bhagwat-rahul/reversible-mac/src/reversible_stdcells/layout/views/rev_cnot/rev_cnot.png

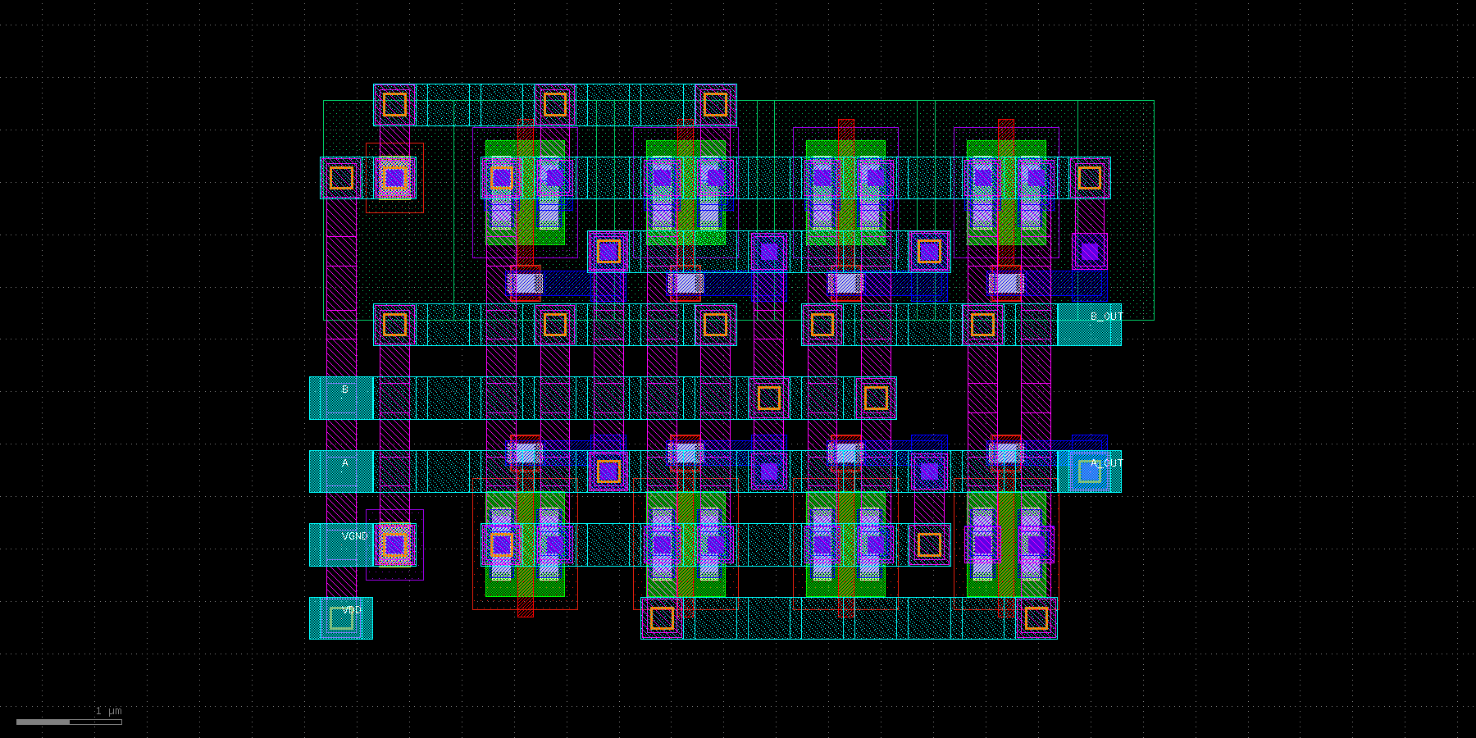
src/reversible_stdcells/layout/views/rev_cnot/rev_cnot.png
