bhagwat-rahul/reversible-mac/src/reversible_stdcells/layout/views/rev_not/rev_not.png

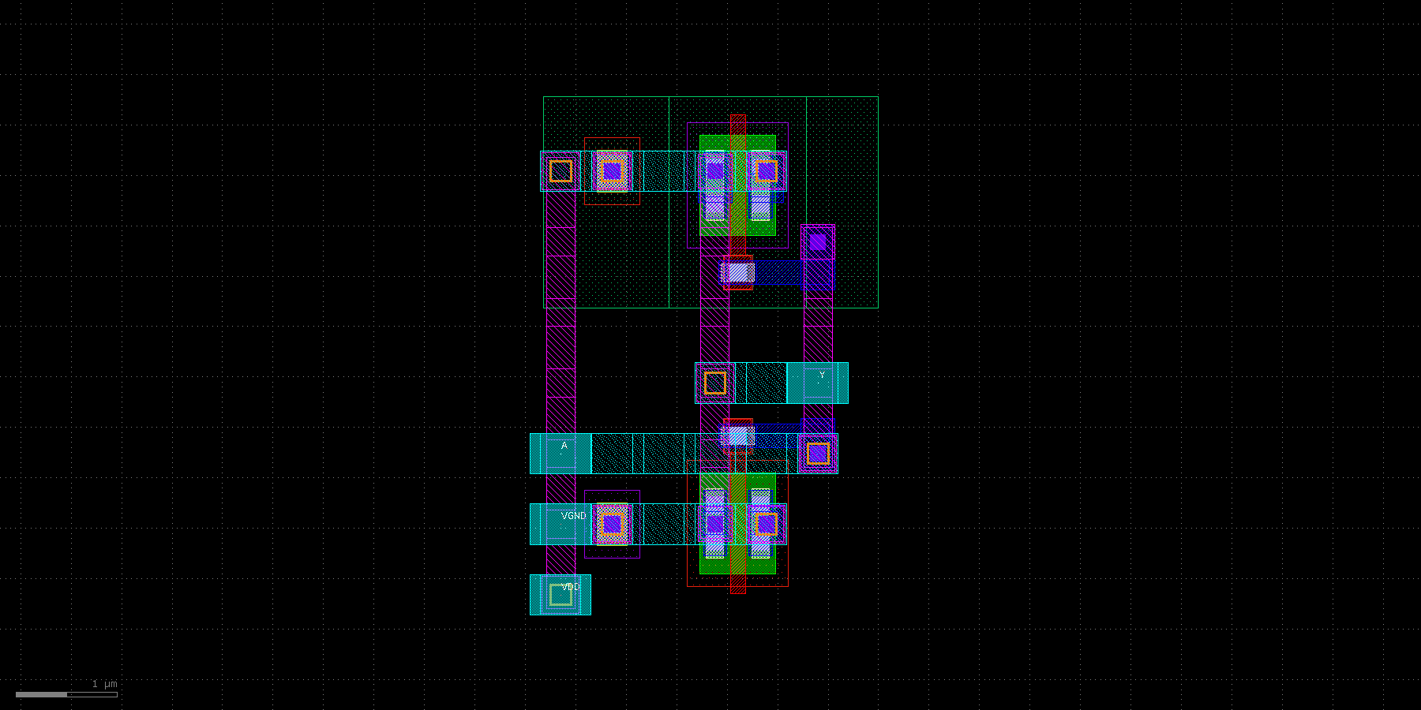
src/reversible_stdcells/layout/views/rev_not/rev_not.png
