bhagwat-rahul/reversible-mac/src/reversible_stdcells/layout/views/rev_toffoli/rev_toffoli.png

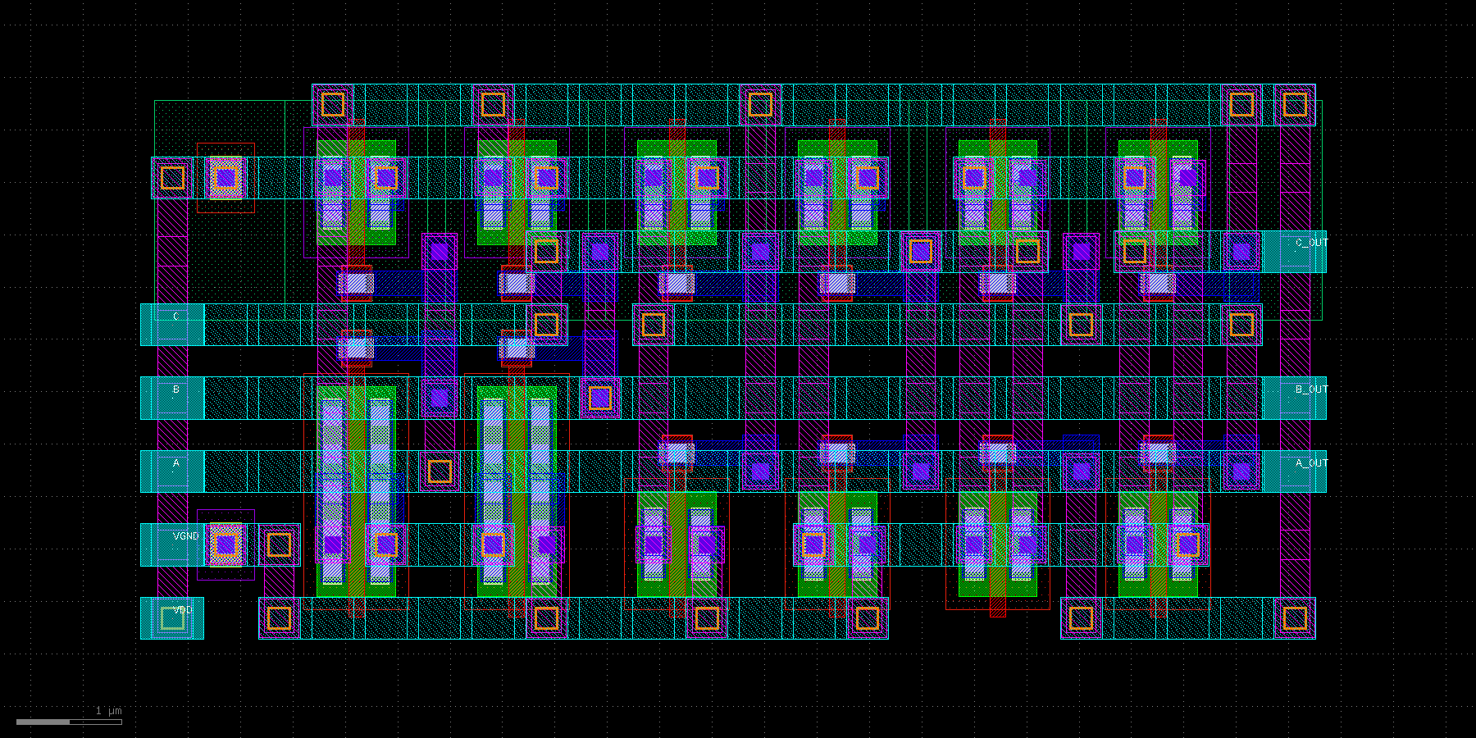
src/reversible_stdcells/layout/views/rev_toffoli/rev_toffoli.png
