bhagwat-rahul/reversible-mac/src/reversible_stdcells/layout/characterization/summary.csv

cell | corner | vdd_V | temp_C | truth_rows | directed_transitions | status | max_delay_ps | max_slew_20_80_ps
rev_not | tt | 1.8 | 27 | 2 | 2 | PASS | 94.8238 | 94.0069
rev_not | tt | 1.62 | 125 | 2 | 2 | PASS | 97.2895 | 100.489
rev_not | tt | 1.98 | -40 | 2 | 2 | PASS | 89.1665 | 86.5556
rev_not | ss | 1.8 | 27 | 2 | 2 | PASS | 128.458 | 131.5136
rev_not | ss | 1.62 | 125 | 2 | 2 | PASS | 131.9486 | 139.894
rev_not | ss | 1.98 | -40 | 2 | 2 | PASS | 119.2281 | 119.693
rev_not | ff | 1.8 | 27 | 2 | 2 | PASS | 74.9453 | 74.0854
rev_not | ff | 1.62 | 125 | 2 | 2 | PASS | 79.4098 | 80.5801
rev_not | ff | 1.98 | -40 | 2 | 2 | PASS | 70.7127 | 70.9175
rev_not | sf | 1.8 | 27 | 2 | 2 | PASS | 130.164 | 132.948
rev_not | sf | 1.62 | 125 | 2 | 2 | PASS | 137.0584 | 146.5867
rev_not | sf | 1.98 | -40 | 2 | 2 | PASS | 117.4135 | 115.9452
rev_not | fs | 1.8 | 27 | 2 | 2 | PASS | 74.0782 | 73.8267
rev_not | fs | 1.62 | 125 | 2 | 2 | PASS | 80.8062 | 82.8792
rev_not | fs | 1.98 | -40 | 2 | 2 | PASS | 68.6971 | 69.5787
rev_cnot | tt | 1.8 | 27 | 4 | 8 | PASS | 188.8786 | 247.7548
rev_cnot | tt | 1.62 | 125 | 4 | 8 | PASS | 204.3251 | 271.7079
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
