bhagwat-rahul/reversible-mac/src/reversible_stdcells/layout/characterization/timing.csv

cell | corner | vdd_V | temp_C | input | output | before | after | output_edge | delay_ps | slew_20_80_ps | ideal_wire
rev_not | tt | 1.8 | 27 | A | Y | 0 | 1 | fall | 50.8846 | 34.7106 | False
rev_not | tt | 1.8 | 27 | A | Y | 1 | 0 | rise | 94.8238 | 94.0069 | False
rev_not | tt | 1.62 | 125 | A | Y | 0 | 1 | fall | 60.8213 | 42.9861 | False
rev_not | tt | 1.62 | 125 | A | Y | 1 | 0 | rise | 97.2895 | 100.489 | False
rev_not | tt | 1.98 | -40 | A | Y | 0 | 1 | fall | 43.4602 | 30.8887 | False
rev_not | tt | 1.98 | -40 | A | Y | 1 | 0 | rise | 89.1665 | 86.5556 | False
rev_not | ss | 1.8 | 27 | A | Y | 0 | 1 | fall | 58.6605 | 38.068 | False
rev_not | ss | 1.8 | 27 | A | Y | 1 | 0 | rise | 128.458 | 131.5136 | False
rev_not | ss | 1.62 | 125 | A | Y | 0 | 1 | fall | 72.1066 | 51.0955 | False
rev_not | ss | 1.62 | 125 | A | Y | 1 | 0 | rise | 131.9486 | 139.894 | False
rev_not | ss | 1.98 | -40 | A | Y | 0 | 1 | fall | 49.837 | 31.8768 | False
rev_not | ss | 1.98 | -40 | A | Y | 1 | 0 | rise | 119.2281 | 119.693 | False
rev_not | ff | 1.8 | 27 | A | Y | 0 | 1 | fall | 43.6311 | 33.8588 | False
rev_not | ff | 1.8 | 27 | A | Y | 1 | 0 | rise | 74.9453 | 74.0854 | False
rev_not | ff | 1.62 | 125 | A | Y | 0 | 1 | fall | 52.1281 | 39.0048 | False
rev_not | ff | 1.62 | 125 | A | Y | 1 | 0 | rise | 79.4098 | 80.5801 | False
rev_not | ff | 1.98 | -40 | A | Y | 0 | 1 | fall | 36.9041 | 31.3239 | False
rev_not | ff | 1.98 | -40 | A | Y | 1 | 0 | rise | 70.7127 | 70.9175 | False
rev_not | sf | 1.8 | 27 | A | Y | 0 | 1 | fall | 42.9238 | 33.6043 | False
rev_not | sf | 1.8 | 27 | A | Y | 1 | 0 | rise | 130.164 | 132.948 | False
rev_not | sf | 1.62 | 125 | A | Y | 0 | 1 | fall | 51.2985 | 38.6279 | False
rev_not | sf | 1.62 | 125 | A | Y | 1 | 0 | rise | 137.0584 | 146.5867 | False
rev_not | sf | 1.98 | -40 | A | Y | 0 | 1 | fall | 36.2476 | 31.2423 | False
rev_not | sf | 1.98 | -40 | A | Y | 1 | 0 | rise | 117.4135 | 115.9452 | False
rev_not | fs | 1.8 | 27 | A | Y | 0 | 1 | fall | 59.468 | 38.147 | False
rev_not | fs | 1.8 | 27 | A | Y | 1 | 0 | rise | 74.0782 | 73.8267 | False
rev_not | fs | 1.62 | 125 | A | Y | 0 | 1 | fall | 73.7753 | 52.284 | False
rev_not | fs | 1.62 | 125 | A | Y | 1 | 0 | rise | 80.8062 | 82.8792 | False
rev_not | fs | 1.98 | -40 | A | Y | 0 | 1 | fall | 50.2643 | 31.4972 | False
rev_not | fs | 1.98 | -40 | A | Y | 1 | 0 | rise | 68.6971 | 69.5787 | False
rev_cnot | tt | 1.8 | 27 | A | A_OUT | 00 | 10 | rise | 0.0 | 60.0 | True
rev_cnot | tt | 1.8 | 27 | A | B_OUT | 00 | 10 | rise | 140.6922 | 232.3154 | False
rev_cnot | tt | 1.8 | 27 | B | B_OUT | 00 | 01 | rise | 48.1538 | 132.059 | False
rev_cnot | tt | 1.8 | 27 | A | A_OUT | 01 | 11 | rise | 0.0 | 60.0 | True
rev_cnot | tt | 1.8 | 27 | A | B_OUT | 01 | 11 | fall | 66.3974 | 60.8024 | False
rev_cnot | tt | 1.8 | 27 | B | B_OUT | 01 | 00 | fall | 47.8448 | 55.7099 | False
rev_cnot | tt | 1.8 | 27 | A | A_OUT | 10 | 00 | fall | 0.0 | 60.0 | True
rev_cnot | tt | 1.8 | 27 | A | B_OUT | 10 | 00 | fall | 102.8928 | 57.9365 | False
rev_cnot | tt | 1.8 | 27 | B | B_OUT | 10 | 11 | fall | 91.3338 | 63.5462 | False
rev_cnot | tt | 1.8 | 27 | A | A_OUT | 11 | 01 | fall | 0.0 | 60.0 | True
rev_cnot | tt | 1.8 | 27 | A | B_OUT | 11 | 01 | rise | 103.6772 | 111.3175 | False
rev_cnot | tt | 1.8 | 27 | B | B_OUT | 11 | 10 | rise | 188.8786 | 247.7548 | False
rev_cnot | tt | 1.62 | 125 | A | A_OUT | 00 | 10 | rise | 0.0 | 60.0 | True
rev_cnot | tt | 1.62 | 125 | A | B_OUT | 00 | 10 | rise | 159.7484 | 257.2705 | False
rev_cnot | tt | 1.62 | 125 | B | B_OUT | 00 | 01 | rise | 54.8647 | 138.4132 | False
rev_cnot | tt | 1.62 | 125 | A | A_OUT | 01 | 11 | rise | 0.0 | 60.0 | True
rev_cnot | tt | 1.62 | 125 | A | B_OUT | 01 | 11 | fall | 84.6317 | 86.733 | False
rev_cnot | tt | 1.62 | 125 | B | B_OUT | 01 | 00 | fall | 54.0511 | 66.6337 | False
rev_cnot | tt | 1.62 | 125 | A | A_OUT | 10 | 00 | fall | 0.0 | 60.0 | True
rev_cnot | tt | 1.62 | 125 | A | B_OUT | 10 | 00 | fall | 112.6734 | 73.057 | False
rev_cnot | tt | 1.62 | 125 | B | B_OUT | 10 | 11 | fall | 116.3348 | 92.336 | False
rev_cnot | tt | 1.62 | 125 | A | A_OUT | 11 | 01 | fall | 0.0 | 60.0 | True
rev_cnot | tt | 1.62 | 125 | A | B_OUT | 11 | 01 | rise | 107.5925 | 120.0515 | False
rev_cnot | tt | 1.62 | 125 | B | B_OUT | 11 | 10 | rise | 204.3251 | 271.7079 | False
rev_cnot | tt | 1.98 | -40 | A | A_OUT | 00 | 10 | rise | 0.0 | 60.0 | True
rev_cnot | tt | 1.98 | -40 | A | B_OUT | 00 | 10 | rise | 120.9535 | 205.3493 | False
rev_cnot | tt | 1.98 | -40 | B | B_OUT | 00 | 01 | rise | 40.5454 | 123.8615 | False
rev_cnot | tt | 1.98 | -40 | A | A_OUT | 01 | 11 | rise | 0.0 | 60.0 | True
rev_cnot | tt | 1.98 | -40 | A | B_OUT | 01 | 11 | fall | 54.3832 | 46.8483 | False
rev_cnot | tt | 1.98 | -40 | B | B_OUT | 01 | 00 | fall | 42.2526 | 49.4588 | False
rev_cnot | tt | 1.98 | -40 | A | A_OUT | 10 | 00 | fall | 0.0 | 60.0 | True
rev_cnot | tt | 1.98 | -40 | A | B_OUT | 10 | 00 | fall | 92.5668 | 48.043 | False
rev_cnot | tt | 1.98 | -40 | B | B_OUT | 10 | 11 | fall | 75.0309 | 47.2699 | False
rev_cnot | tt | 1.98 | -40 | A | A_OUT | 11 | 01 | fall | 0.0 | 60.0 | True
rev_cnot | tt | 1.98 | -40 | A | B_OUT | 11 | 01 | rise | 96.1563 | 101.307 | False
rev_cnot | tt | 1.98 | -40 | B | B_OUT | 11 | 10 | rise | 168.4699 | 221.3229 | False
rev_cnot | ss | 1.8 | 27 | A | A_OUT | 00 | 10 | rise | 0.0 | 60.0 | True
rev_cnot | ss | 1.8 | 27 | A | B_OUT | 00 | 10 | rise | 200.9691 | 340.167 | False
rev_cnot | ss | 1.8 | 27 | B | B_OUT | 00 | 01 | rise | 63.8168 | 170.3515 | False
rev_cnot | ss | 1.8 | 27 | A | A_OUT | 01 | 11 | rise | 0.0 | 60.0 | True
rev_cnot | ss | 1.8 | 27 | A | B_OUT | 01 | 11 | fall | 80.4799 | 73.846 | False
rev_cnot | ss | 1.8 | 27 | B | B_OUT | 01 | 00 | fall | 57.6008 | 59.1927 | False
rev_cnot | ss | 1.8 | 27 | A | A_OUT | 10 | 00 | fall | 0.0 | 60.0 | True
rev_cnot | ss | 1.8 | 27 | A | B_OUT | 10 | 00 | fall | 139.75 | 73.2689 | False
rev_cnot | ss | 1.8 | 27 | B | B_OUT | 10 | 11 | fall | 111.115 | 77.9985 | False
rev_cnot | ss | 1.8 | 27 | A | A_OUT | 11 | 01 | fall | 0.0 | 60.0 | True
rev_cnot | ss | 1.8 | 27 | A | B_OUT | 11 | 01 | rise | 143.1473 | 157.7493 | False
rev_cnot | ss | 1.8 | 27 | B | B_OUT | 11 | 10 | rise | 274.0051 | 359.4857 | False
rev_cnot | ss | 1.62 | 125 | A | A_OUT | 00 | 10 | rise | 0.0 | 60.0 | True
rev_cnot | ss | 1.62 | 125 | A | B_OUT | 00 | 10 | rise | 226.2285 | 372.8059 | False
rev_cnot | ss | 1.62 | 125 | B | B_OUT | 00 | 01 | rise | 74.4654 | 180.7988 | False
rev_cnot | ss | 1.62 | 125 | A | A_OUT | 01 | 11 | rise | 0.0 | 60.0 | True
rev_cnot | ss | 1.62 | 125 | A | B_OUT | 01 | 11 | fall | 107.2095 | 113.0137 | False
rev_cnot | ss | 1.62 | 125 | B | B_OUT | 01 | 00 | fall | 67.3718 | 76.3632 | False
rev_cnot | ss | 1.62 | 125 | A | A_OUT | 10 | 00 | fall | 0.0 | 60.0 | True
rev_cnot | ss | 1.62 | 125 | A | B_OUT | 10 | 00 | fall | 155.3688 | 95.9913 | False
rev_cnot | ss | 1.62 | 125 | B | B_OUT | 10 | 11 | fall | 148.0193 | 119.306 | False
rev_cnot | ss | 1.62 | 125 | A | A_OUT | 11 | 01 | fall | 0.0 | 60.0 | True
rev_cnot | ss | 1.62 | 125 | A | B_OUT | 11 | 01 | rise | 148.1143 | 168.7293 | False
rev_cnot | ss | 1.62 | 125 | B | B_OUT | 11 | 10 | rise | 294.8149 | 392.3502 | False
rev_cnot | ss | 1.98 | -40 | A | A_OUT | 00 | 10 | rise | 0.0 | 60.0 | True
rev_cnot | ss | 1.98 | -40 | A | B_OUT | 00 | 10 | rise | 171.7918 | 298.5422 | False
rev_cnot | ss | 1.98 | -40 | B | B_OUT | 00 | 01 | rise | 53.0541 | 155.8779 | False
rev_cnot | ss | 1.98 | -40 | A | A_OUT | 01 | 11 | rise | 0.0 | 60.0 | True
rev_cnot | ss | 1.98 | -40 | A | B_OUT | 01 | 11 | fall | 63.725 | 52.9904 | False
rev_cnot | ss | 1.98 | -40 | B | B_OUT | 01 | 00 | fall | 50.0802 | 49.8892 | False
rev_cnot | ss | 1.98 | -40 | A | A_OUT | 10 | 00 | fall | 0.0 | 60.0 | True
rev_cnot | ss | 1.98 | -40 | A | B_OUT | 10 | 00 | fall | 123.0162 | 58.8739 | False
rev_cnot | ss | 1.98 | -40 | B | B_OUT | 10 | 11 | fall | 87.871 | 54.805 | False
rev_cnot | ss | 1.98 | -40 | A | A_OUT | 11 | 01 | fall | 0.0 | 60.0 | True
rev_cnot | ss | 1.98 | -40 | A | B_OUT | 11 | 01 | rise | 131.5463 | 142.5902 | False
rev_cnot | ss | 1.98 | -40 | B | B_OUT | 11 | 10 | rise | 241.8469 | 317.1326 | False
rev_cnot | ff | 1.8 | 27 | A | A_OUT | 00 | 10 | rise | 0.0 | 60.0 | True
rev_cnot | ff | 1.8 | 27 | A | B_OUT | 00 | 10 | rise | 104.1547 | 170.9508 | False
rev_cnot | ff | 1.8 | 27 | B | B_OUT | 00 | 01 | rise | 36.3806 | 110.154 | False
rev_cnot | ff | 1.8 | 27 | A | A_OUT | 01 | 11 | rise | 0.0 | 60.0 | True
rev_cnot | ff | 1.8 | 27 | A | B_OUT | 01 | 11 | fall | 55.129 | 52.8235 | False
rev_cnot | ff | 1.8 | 27 | B | B_OUT | 01 | 00 | fall | 39.6704 | 54.308 | False
rev_cnot | ff | 1.8 | 27 | A | A_OUT | 10 | 00 | fall | 0.0 | 60.0 | True
rev_cnot | ff | 1.8 | 27 | A | B_OUT | 10 | 00 | fall | 80.1829 | 48.0396 | False
rev_cnot | ff | 1.8 | 27 | B | B_OUT | 10 | 11 | fall | 76.7633 | 54.3077 | False
rev_cnot | ff | 1.8 | 27 | A | A_OUT | 11 | 01 | fall | 0.0 | 60.0 | True
rev_cnot | ff | 1.8 | 27 | A | B_OUT | 11 | 01 | rise | 80.0837 | 85.3624 | False
rev_cnot | ff | 1.8 | 27 | B | B_OUT | 11 | 10 | rise | 139.83 | 184.7196 | False
rev_cnot | ff | 1.62 | 125 | A | A_OUT | 00 | 10 | rise | 0.0 | 60.0 | True
rev_cnot | ff | 1.62 | 125 | A | B_OUT | 00 | 10 | rise | 121.2577 | 194.8915 | False
rev_cnot | ff | 1.62 | 125 | B | B_OUT | 00 | 01 | rise | 43.2675 | 115.9133 | False
rev_cnot | ff | 1.62 | 125 | A | A_OUT | 01 | 11 | rise | 0.0 | 60.0 | True
rev_cnot | ff | 1.62 | 125 | A | B_OUT | 01 | 11 | fall | 68.6158 | 70.6224 | False
rev_cnot | ff | 1.62 | 125 | B | B_OUT | 01 | 00 | fall | 45.1907 | 61.2934 | False
rev_cnot | ff | 1.62 | 125 | A | A_OUT | 10 | 00 | fall | 0.0 | 60.0 | True
rev_cnot | ff | 1.62 | 125 | A | B_OUT | 10 | 00 | fall | 89.1537 | 59.0149 | False
rev_cnot | ff | 1.62 | 125 | B | B_OUT | 10 | 11 | fall | 95.0682 | 74.8172 | False
rev_cnot | ff | 1.62 | 125 | A | A_OUT | 11 | 01 | fall | 0.0 | 60.0 | True
rev_cnot | ff | 1.62 | 125 | A | B_OUT | 11 | 01 | rise | 86.0325 | 94.1628 | False
rev_cnot | ff | 1.62 | 125 | B | B_OUT | 11 | 10 | rise | 156.3398 | 207.3407 | False
rev_cnot | ff | 1.98 | -40 | A | A_OUT | 00 | 10 | rise | 0.0 | 60.0 | True
rev_cnot | ff | 1.98 | -40 | A | B_OUT | 00 | 10 | rise | 91.036 | 156.7709 | False
rev_cnot | ff | 1.98 | -40 | B | B_OUT | 00 | 01 | rise | 29.1015 | 106.1115 | False
rev_cnot | ff | 1.98 | -40 | A | A_OUT | 01 | 11 | rise | 0.0 | 60.0 | True
rev_cnot | ff | 1.98 | -40 | A | B_OUT | 01 | 11 | fall | 45.7458 | 43.1946 | False
rev_cnot | ff | 1.98 | -40 | B | B_OUT | 01 | 00 | fall | 34.9439 | 49.7274 | False
rev_cnot | ff | 1.98 | -40 | A | A_OUT | 10 | 00 | fall | 0.0 | 60.0 | True
rev_cnot | ff | 1.98 | -40 | A | B_OUT | 10 | 00 | fall | 72.6251 | 41.4953 | False
rev_cnot | ff | 1.98 | -40 | B | B_OUT | 10 | 11 | fall | 64.7337 | 43.3159 | False
rev_cnot | ff | 1.98 | -40 | A | A_OUT | 11 | 01 | fall | 0.0 | 60.0 | True
rev_cnot | ff | 1.98 | -40 | A | B_OUT | 11 | 01 | rise | 74.4826 | 80.4287 | False
rev_cnot | ff | 1.98 | -40 | B | B_OUT | 11 | 10 | rise | 125.9937 | 170.5003 | False
rev_cnot | sf | 1.8 | 27 | A | A_OUT | 00 | 10 | rise | 0.0 | 60.0 | True
rev_cnot | sf | 1.8 | 27 | A | B_OUT | 00 | 10 | rise | 152.8283 | 321.3876 | False
rev_cnot | sf | 1.8 | 27 | B | B_OUT | 00 | 01 | rise | 42.6861 | 153.0774 | False
rev_cnot | sf | 1.8 | 27 | A | A_OUT | 01 | 11 | rise | 0.0 | 60.0 | True
rev_cnot | sf | 1.8 | 27 | A | B_OUT | 01 | 11 | fall | 56.0094 | 52.8323 | False
rev_cnot | sf | 1.8 | 27 | B | B_OUT | 01 | 00 | fall | 46.7782 | 48.7042 | False
rev_cnot | sf | 1.8 | 27 | A | A_OUT | 10 | 00 | fall | 0.0 | 60.0 | True
rev_cnot | sf | 1.8 | 27 | A | B_OUT | 10 | 00 | fall | 124.1258 | 58.682 | False
rev_cnot | sf | 1.8 | 27 | B | B_OUT | 10 | 11 | fall | 79.1173 | 53.1787 | False
rev_cnot | sf | 1.8 | 27 | A | A_OUT | 11 | 01 | fall | 0.0 | 60.0 | True
rev_cnot | sf | 1.8 | 27 | A | B_OUT | 11 | 01 | rise | 134.307 | 147.7336 | False
rev_cnot | sf | 1.8 | 27 | B | B_OUT | 11 | 10 | rise | 239.006 | 342.6523 | False
rev_cnot | sf | 1.62 | 125 | A | A_OUT | 00 | 10 | rise | 0.0 | 60.0 | True
rev_cnot | sf | 1.62 | 125 | A | B_OUT | 00 | 10 | rise | 178.2536 | 369.1235 | False
rev_cnot | sf | 1.62 | 125 | B | B_OUT | 00 | 01 | rise | 50.9841 | 168.7987 | False
rev_cnot | sf | 1.62 | 125 | A | A_OUT | 01 | 11 | rise | 0.0 | 60.0 | True
rev_cnot | sf | 1.62 | 125 | A | B_OUT | 01 | 11 | fall | 70.0031 | 70.5143 | False
rev_cnot | sf | 1.62 | 125 | B | B_OUT | 01 | 00 | fall | 53.276 | 57.0602 | False
rev_cnot | sf | 1.62 | 125 | A | A_OUT | 10 | 00 | fall | 0.0 | 60.0 | True
rev_cnot | sf | 1.62 | 125 | A | B_OUT | 10 | 00 | fall | 137.6415 | 72.4534 | False
rev_cnot | sf | 1.62 | 125 | B | B_OUT | 10 | 11 | fall | 98.868 | 73.8113 | False
rev_cnot | sf | 1.62 | 125 | A | A_OUT | 11 | 01 | fall | 0.0 | 60.0 | True
rev_cnot | sf | 1.62 | 125 | A | B_OUT | 11 | 01 | rise | 145.7714 | 167.7924 | False
rev_cnot | sf | 1.62 | 125 | B | B_OUT | 11 | 10 | rise | 266.5165 | 390.342 | False
rev_cnot | sf | 1.98 | -40 | A | A_OUT | 00 | 10 | rise | 0.0 | 60.0 | True
rev_cnot | sf | 1.98 | -40 | A | B_OUT | 00 | 10 | rise | 125.5919 | 269.8068 | False
rev_cnot | sf | 1.98 | -40 | B | B_OUT | 00 | 01 | rise | 33.4922 | 136.75 | False
rev_cnot | sf | 1.98 | -40 | A | A_OUT | 01 | 11 | rise | 0.0 | 60.0 | True
rev_cnot | sf | 1.98 | -40 | A | B_OUT | 01 | 11 | fall | 46.571 | 43.4696 | False
rev_cnot | sf | 1.98 | -40 | B | B_OUT | 01 | 00 | fall | 40.9298 | 44.4052 | False
rev_cnot | sf | 1.98 | -40 | A | A_OUT | 10 | 00 | fall | 0.0 | 60.0 | True
rev_cnot | sf | 1.98 | -40 | A | B_OUT | 10 | 00 | fall | 109.183 | 49.067 | False
rev_cnot | sf | 1.98 | -40 | B | B_OUT | 10 | 11 | fall | 66.1893 | 42.1216 | False
rev_cnot | sf | 1.98 | -40 | A | A_OUT | 11 | 01 | fall | 0.0 | 60.0 | True
rev_cnot | sf | 1.98 | -40 | A | B_OUT | 11 | 01 | rise | 117.8882 | 125.2103 | False
rev_cnot | sf | 1.98 | -40 | B | B_OUT | 11 | 10 | rise | 203.6922 | 289.7277 | False
rev_cnot | fs | 1.8 | 27 | A | A_OUT | 00 | 10 | rise | 0.0 | 60.0 | True
rev_cnot | fs | 1.8 | 27 | A | B_OUT | 00 | 10 | rise | 131.7733 | 177.5811 | False
rev_cnot | fs | 1.8 | 27 | B | B_OUT | 00 | 01 | rise | 48.5049 | 114.4813 | False
rev_cnot | fs | 1.8 | 27 | A | A_OUT | 01 | 11 | rise | 0.0 | 60.0 | True
rev_cnot | fs | 1.8 | 27 | A | B_OUT | 01 | 11 | fall | 78.1332 | 73.1353 | False
rev_cnot | fs | 1.8 | 27 | B | B_OUT | 01 | 00 | fall | 47.6871 | 66.2366 | False
rev_cnot | fs | 1.8 | 27 | A | A_OUT | 10 | 00 | fall | 0.0 | 60.0 | True
rev_cnot | fs | 1.8 | 27 | A | B_OUT | 10 | 00 | fall | 88.5709 | 60.1676 | False
rev_cnot | fs | 1.8 | 27 | B | B_OUT | 10 | 11 | fall | 105.4768 | 78.5407 | False
rev_cnot | fs | 1.8 | 27 | A | A_OUT | 11 | 01 | fall | 0.0 | 60.0 | True
rev_cnot | fs | 1.8 | 27 | A | B_OUT | 11 | 01 | rise | 82.2669 | 88.0274 | False
rev_cnot | fs | 1.8 | 27 | B | B_OUT | 11 | 10 | rise | 154.8425 | 189.4564 | False
rev_cnot | fs | 1.62 | 125 | A | A_OUT | 00 | 10 | rise | 0.0 | 60.0 | True
rev_cnot | fs | 1.62 | 125 | A | B_OUT | 00 | 10 | rise | 155.8652 | 205.4333 | False
rev_cnot | fs | 1.62 | 125 | B | B_OUT | 00 | 01 | rise | 56.4887 | 121.1697 | False
rev_cnot | fs | 1.62 | 125 | A | A_OUT | 01 | 11 | rise | 0.0 | 60.0 | True
rev_cnot | fs | 1.62 | 125 | A | B_OUT | 01 | 11 | fall | 103.7313 | 112.8249 | False
rev_cnot | fs | 1.62 | 125 | B | B_OUT | 01 | 00 | fall | 55.3525 | 80.1419 | False
rev_cnot | fs | 1.62 | 125 | A | A_OUT | 10 | 00 | fall | 0.0 | 60.0 | True
rev_cnot | fs | 1.62 | 125 | A | B_OUT | 10 | 00 | fall | 102.7467 | 80.4966 | False
rev_cnot | fs | 1.62 | 125 | B | B_OUT | 10 | 11 | fall | 140.1504 | 121.5885 | False
rev_cnot | fs | 1.62 | 125 | A | A_OUT | 11 | 01 | fall | 0.0 | 60.0 | True
rev_cnot | fs | 1.62 | 125 | A | B_OUT | 11 | 01 | rise | 90.1874 | 99.4413 | False
rev_cnot | fs | 1.62 | 125 | B | B_OUT | 11 | 10 | rise | 177.5565 | 216.4492 | False
rev_cnot | fs | 1.98 | -40 | A | A_OUT | 00 | 10 | rise | 0.0 | 60.0 | True
rev_cnot | fs | 1.98 | -40 | A | B_OUT | 00 | 10 | rise | 114.4636 | 161.3789 | False
rev_cnot | fs | 1.98 | -40 | B | B_OUT | 00 | 01 | rise | 41.2213 | 110.3675 | False
rev_cnot | fs | 1.98 | -40 | A | A_OUT | 01 | 11 | rise | 0.0 | 60.0 | True
rev_cnot | fs | 1.98 | -40 | A | B_OUT | 01 | 11 | fall | 61.7956 | 51.8248 | False
rev_cnot | fs | 1.98 | -40 | B | B_OUT | 01 | 00 | fall | 41.7124 | 57.5981 | False
rev_cnot | fs | 1.98 | -40 | A | A_OUT | 10 | 00 | fall | 0.0 | 60.0 | True
rev_cnot | fs | 1.98 | -40 | A | B_OUT | 10 | 00 | fall | 77.8799 | 48.4366 | False
rev_cnot | fs | 1.98 | -40 | B | B_OUT | 10 | 11 | fall | 83.8252 | 54.4659 | False
rev_cnot | fs | 1.98 | -40 | A | A_OUT | 11 | 01 | fall | 0.0 | 60.0 | True
rev_cnot | fs | 1.98 | -40 | A | B_OUT | 11 | 01 | rise | 75.969 | 82.4084 | False
rev_cnot | fs | 1.98 | -40 | B | B_OUT | 11 | 10 | rise | 137.6527 | 173.3842 | False
rev_toffoli | tt | 1.8 | 27 | A | A_OUT | 000 | 100 | rise | 0.0 | 60.0 | True
rev_toffoli | tt | 1.8 | 27 | B | B_OUT | 000 | 010 | rise | 0.0 | 60.0 | True
rev_toffoli | tt | 1.8 | 27 | C | C_OUT | 000 | 001 | rise | 50.6076 | 134.5288 | False
rev_toffoli | tt | 1.8 | 27 | A | A_OUT | 001 | 101 | rise | 0.0 | 60.0 | True
rev_toffoli | tt | 1.8 | 27 | B | B_OUT | 001 | 011 | rise | 0.0 | 60.0 | True
rev_toffoli | tt | 1.8 | 27 | C | C_OUT | 001 | 000 | fall | 46.8376 | 54.9325 | False
rev_toffoli | tt | 1.8 | 27 | A | A_OUT | 010 | 110 | rise | 0.0 | 60.0 | True
rev_toffoli | tt | 1.8 | 27 | A | C_OUT | 010 | 110 | rise | 182.918 | 220.4127 | False
rev_toffoli | tt | 1.8 | 27 | B | B_OUT | 010 | 000 | fall | 0.0 | 60.0 | True
rev_toffoli | tt | 1.8 | 27 | C | C_OUT | 010 | 011 | rise | 48.8546 | 133.2017 | False
rev_toffoli | tt | 1.8 | 27 | A | A_OUT | 011 | 111 | rise | 0.0 | 60.0 | True
rev_toffoli | tt | 1.8 | 27 | A | C_OUT | 011 | 111 | fall | 141.9861 | 77.5878 | False
rev_toffoli | tt | 1.8 | 27 | B | B_OUT | 011 | 001 | fall | 0.0 | 60.0 | True
rev_toffoli | tt | 1.8 | 27 | C | C_OUT | 011 | 010 | fall | 47.7734 | 56.2993 | False
rev_toffoli | tt | 1.8 | 27 | A | A_OUT | 100 | 000 | fall | 0.0 | 60.0 | True
rev_toffoli | tt | 1.8 | 27 | B | B_OUT | 100 | 110 | rise | 0.0 | 60.0 | True
rev_toffoli | tt | 1.8 | 27 | B | C_OUT | 100 | 110 | rise | 187.5995 | 220.5191 | False
rev_toffoli | tt | 1.8 | 27 | C | C_OUT | 100 | 101 | rise | 48.8578 | 133.2044 | False
rev_toffoli | tt | 1.8 | 27 | A | A_OUT | 101 | 001 | fall | 0.0 | 60.0 | True
rev_toffoli | tt | 1.8 | 27 | B | B_OUT | 101 | 111 | rise | 0.0 | 60.0 | True
rev_toffoli | tt | 1.8 | 27 | B | C_OUT | 101 | 111 | fall | 146.0202 | 77.5909 | False
rev_toffoli | tt | 1.8 | 27 | C | C_OUT | 101 | 100 | fall | 47.7757 | 56.3014 | False
rev_toffoli | tt | 1.8 | 27 | A | A_OUT | 110 | 010 | fall | 0.0 | 60.0 | True
rev_toffoli | tt | 1.8 | 27 | A | C_OUT | 110 | 010 | fall | 161.2978 | 59.4418 | False
rev_toffoli | tt | 1.8 | 27 | B | B_OUT | 110 | 100 | fall | 0.0 | 60.0 | True
rev_toffoli | tt | 1.8 | 27 | B | C_OUT | 110 | 100 | fall | 193.1309 | 61.1836 | False
rev_toffoli | tt | 1.8 | 27 | C | C_OUT | 110 | 111 | fall | 92.2495 | 66.6388 | False
rev_toffoli | tt | 1.8 | 27 | A | A_OUT | 111 | 011 | fall | 0.0 | 60.0 | True
rev_toffoli | tt | 1.8 | 27 | A | C_OUT | 111 | 011 | rise | 187.3904 | 111.0777 | False
rev_toffoli | tt | 1.8 | 27 | B | B_OUT | 111 | 101 | fall | 0.0 | 60.0 | True
rev_toffoli | tt | 1.8 | 27 | B | C_OUT | 111 | 101 | rise | 219.5764 | 111.7475 | False
rev_toffoli | tt | 1.8 | 27 | C | C_OUT | 111 | 110 | rise | 182.0383 | 244.1175 | False
rev_toffoli | tt | 1.62 | 125 | A | A_OUT | 000 | 100 | rise | 0.0 | 60.0 | True
rev_toffoli | tt | 1.62 | 125 | B | B_OUT | 000 | 010 | rise | 0.0 | 60.0 | True
rev_toffoli | tt | 1.62 | 125 | C | C_OUT | 000 | 001 | rise | 58.1103 | 141.2504 | False
rev_toffoli | tt | 1.62 | 125 | A | A_OUT | 001 | 101 | rise | 0.0 | 60.0 | True
rev_toffoli | tt | 1.62 | 125 | B | B_OUT | 001 | 011 | rise | 0.0 | 60.0 | True
rev_toffoli | tt | 1.62 | 125 | C | C_OUT | 001 | 000 | fall | 52.7764 | 65.7951 | False
rev_toffoli | tt | 1.62 | 125 | A | A_OUT | 010 | 110 | rise | 0.0 | 60.0 | True
rev_toffoli | tt | 1.62 | 125 | A | C_OUT | 010 | 110 | rise | 211.0588 | 245.3975 | False
rev_toffoli | tt | 1.62 | 125 | B | B_OUT | 010 | 000 | fall | 0.0 | 60.0 | True
rev_toffoli | tt | 1.62 | 125 | C | C_OUT | 010 | 011 | rise | 56.3288 | 140.1008 | False
rev_toffoli | tt | 1.62 | 125 | A | A_OUT | 011 | 111 | rise | 0.0 | 60.0 | True
rev_toffoli | tt | 1.62 | 125 | A | C_OUT | 011 | 111 | fall | 173.73 | 106.803 | False
rev_toffoli | tt | 1.62 | 125 | B | B_OUT | 011 | 001 | fall | 0.0 | 60.0 | True
rev_toffoli | tt | 1.62 | 125 | C | C_OUT | 011 | 010 | fall | 53.8596 | 67.6437 | False
rev_toffoli | tt | 1.62 | 125 | A | A_OUT | 100 | 000 | fall | 0.0 | 60.0 | True
rev_toffoli | tt | 1.62 | 125 | B | B_OUT | 100 | 110 | rise | 0.0 | 60.0 | True
rev_toffoli | tt | 1.62 | 125 | B | C_OUT | 100 | 110 | rise | 217.9854 | 245.4668 | False
rev_toffoli | tt | 1.62 | 125 | C | C_OUT | 100 | 101 | rise | 56.3333 | 140.1041 | False
rev_toffoli | tt | 1.62 | 125 | A | A_OUT | 101 | 001 | fall | 0.0 | 60.0 | True
rev_toffoli | tt | 1.62 | 125 | B | B_OUT | 101 | 111 | rise | 0.0 | 60.0 | True
rev_toffoli | tt | 1.62 | 125 | B | C_OUT | 101 | 111 | fall | 180.1403 | 106.7802 | False
rev_toffoli | tt | 1.62 | 125 | C | C_OUT | 101 | 100 | fall | 53.8632 | 67.6479 | False
rev_toffoli | tt | 1.62 | 125 | A | A_OUT | 110 | 010 | fall | 0.0 | 60.0 | True
rev_toffoli | tt | 1.62 | 125 | A | C_OUT | 110 | 010 | fall | 182.5489 | 73.3645 | False
rev_toffoli | tt | 1.62 | 125 | B | B_OUT | 110 | 100 | fall | 0.0 | 60.0 | True
rev_toffoli | tt | 1.62 | 125 | B | C_OUT | 110 | 100 | fall | 215.8193 | 75.3493 | False
rev_toffoli | tt | 1.62 | 125 | C | C_OUT | 110 | 111 | fall | 117.4917 | 96.0439 | False
rev_toffoli | tt | 1.62 | 125 | A | A_OUT | 111 | 011 | fall | 0.0 | 60.0 | True
rev_toffoli | tt | 1.62 | 125 | A | C_OUT | 111 | 011 | rise | 209.732 | 123.0673 | False
rev_toffoli | tt | 1.62 | 125 | B | B_OUT | 111 | 101 | fall | 0.0 | 60.0 | True
rev_toffoli | tt | 1.62 | 125 | B | C_OUT | 111 | 101 | rise | 243.1842 | 123.66 | False
rev_toffoli | tt | 1.62 | 125 | C | C_OUT | 111 | 110 | rise | 197.6127 | 268.4951 | False
rev_toffoli | tt | 1.98 | -40 | A | A_OUT | 000 | 100 | rise | 0.0 | 60.0 | True
rev_toffoli | tt | 1.98 | -40 | B | B_OUT | 000 | 010 | rise | 0.0 | 60.0 | True
rev_toffoli | tt | 1.98 | -40 | C | C_OUT | 000 | 001 | rise | 42.9512 | 125.9184 | False
rev_toffoli | tt | 1.98 | -40 | A | A_OUT | 001 | 101 | rise | 0.0 | 60.0 | True
rev_toffoli | tt | 1.98 | -40 | B | B_OUT | 001 | 011 | rise | 0.0 | 60.0 | True
rev_toffoli | tt | 1.98 | -40 | C | C_OUT | 001 | 000 | fall | 41.2825 | 48.8064 | False
rev_toffoli | tt | 1.98 | -40 | A | A_OUT | 010 | 110 | rise | 0.0 | 60.0 | True
rev_toffoli | tt | 1.98 | -40 | A | C_OUT | 010 | 110 | rise | 154.7002 | 194.7265 | False
rev_toffoli | tt | 1.98 | -40 | B | B_OUT | 010 | 000 | fall | 0.0 | 60.0 | True
rev_toffoli | tt | 1.98 | -40 | C | C_OUT | 010 | 011 | rise | 40.9379 | 124.6848 | False
rev_toffoli | tt | 1.98 | -40 | A | A_OUT | 011 | 111 | rise | 0.0 | 60.0 | True
rev_toffoli | tt | 1.98 | -40 | A | C_OUT | 011 | 111 | fall | 116.963 | 60.0902 | False
rev_toffoli | tt | 1.98 | -40 | B | B_OUT | 011 | 001 | fall | 0.0 | 60.0 | True
rev_toffoli | tt | 1.98 | -40 | C | C_OUT | 011 | 010 | fall | 42.247 | 49.8021 | False
rev_toffoli | tt | 1.98 | -40 | A | A_OUT | 100 | 000 | fall | 0.0 | 60.0 | True
rev_toffoli | tt | 1.98 | -40 | B | B_OUT | 100 | 110 | rise | 0.0 | 60.0 | True
rev_toffoli | tt | 1.98 | -40 | B | C_OUT | 100 | 110 | rise | 158.4505 | 194.8681 | False
rev_toffoli | tt | 1.98 | -40 | C | C_OUT | 100 | 101 | rise | 40.9411 | 124.6872 | False
rev_toffoli | tt | 1.98 | -40 | A | A_OUT | 101 | 001 | fall | 0.0 | 60.0 | True
rev_toffoli | tt | 1.98 | -40 | B | B_OUT | 101 | 111 | rise | 0.0 | 60.0 | True
rev_toffoli | tt | 1.98 | -40 | B | C_OUT | 101 | 111 | fall | 120.1445 | 59.8832 | False
rev_toffoli | tt | 1.98 | -40 | C | C_OUT | 101 | 100 | fall | 42.2495 | 49.8037 | False
rev_toffoli | tt | 1.98 | -40 | A | A_OUT | 110 | 010 | fall | 0.0 | 60.0 | True
rev_toffoli | tt | 1.98 | -40 | A | C_OUT | 110 | 010 | fall | 142.0599 | 50.085 | False
rev_toffoli | tt | 1.98 | -40 | B | B_OUT | 110 | 100 | fall | 0.0 | 60.0 | True
rev_toffoli | tt | 1.98 | -40 | B | C_OUT | 110 | 100 | fall | 171.617 | 51.8762 | False
rev_toffoli | tt | 1.98 | -40 | C | C_OUT | 110 | 111 | fall | 75.4698 | 49.6608 | False
rev_toffoli | tt | 1.98 | -40 | A | A_OUT | 111 | 011 | fall | 0.0 | 60.0 | True
rev_toffoli | tt | 1.98 | -40 | A | C_OUT | 111 | 011 | rise | 165.7477 | 99.6059 | False
rev_toffoli | tt | 1.98 | -40 | B | B_OUT | 111 | 101 | fall | 0.0 | 60.0 | True
rev_toffoli | tt | 1.98 | -40 | B | C_OUT | 111 | 101 | rise | 195.8192 | 100.4254 | False
rev_toffoli | tt | 1.98 | -40 | C | C_OUT | 111 | 110 | rise | 161.7589 | 217.5893 | False
rev_toffoli | ss | 1.8 | 27 | A | A_OUT | 000 | 100 | rise | 0.0 | 60.0 | True
rev_toffoli | ss | 1.8 | 27 | B | B_OUT | 000 | 010 | rise | 0.0 | 60.0 | True
rev_toffoli | ss | 1.8 | 27 | C | C_OUT | 000 | 001 | rise | 67.6058 | 174.4834 | False
rev_toffoli | ss | 1.8 | 27 | A | A_OUT | 001 | 101 | rise | 0.0 | 60.0 | True
rev_toffoli | ss | 1.8 | 27 | B | B_OUT | 001 | 011 | rise | 0.0 | 60.0 | True
rev_toffoli | ss | 1.8 | 27 | C | C_OUT | 001 | 000 | fall | 55.7901 | 57.759 | False
rev_toffoli | ss | 1.8 | 27 | A | A_OUT | 010 | 110 | rise | 0.0 | 60.0 | True
rev_toffoli | ss | 1.8 | 27 | A | C_OUT | 010 | 110 | rise | 263.6038 | 319.0395 | False
rev_toffoli | ss | 1.8 | 27 | B | B_OUT | 010 | 000 | fall | 0.0 | 60.0 | True
rev_toffoli | ss | 1.8 | 27 | C | C_OUT | 010 | 011 | rise | 64.9314 | 172.27 | False
rev_toffoli | ss | 1.8 | 27 | A | A_OUT | 011 | 111 | rise | 0.0 | 60.0 | True
rev_toffoli | ss | 1.8 | 27 | A | C_OUT | 011 | 111 | fall | 191.8677 | 98.956 | False
rev_toffoli | ss | 1.8 | 27 | B | B_OUT | 011 | 001 | fall | 0.0 | 60.0 | True
rev_toffoli | ss | 1.8 | 27 | C | C_OUT | 011 | 010 | fall | 57.1877 | 59.8954 | False
rev_toffoli | ss | 1.8 | 27 | A | A_OUT | 100 | 000 | fall | 0.0 | 60.0 | True
rev_toffoli | ss | 1.8 | 27 | B | B_OUT | 100 | 110 | rise | 0.0 | 60.0 | True
rev_toffoli | ss | 1.8 | 27 | B | C_OUT | 100 | 110 | rise | 269.3455 | 319.1511 | False
rev_toffoli | ss | 1.8 | 27 | C | C_OUT | 100 | 101 | rise | 64.937 | 172.2747 | False
rev_toffoli | ss | 1.8 | 27 | A | A_OUT | 101 | 001 | fall | 0.0 | 60.0 | True
rev_toffoli | ss | 1.8 | 27 | B | B_OUT | 101 | 111 | rise | 0.0 | 60.0 | True
rev_toffoli | ss | 1.8 | 27 | B | C_OUT | 101 | 111 | fall | 196.8899 | 98.9602 | False
rev_toffoli | ss | 1.8 | 27 | C | C_OUT | 101 | 100 | fall | 57.192 | 59.8992 | False
rev_toffoli | ss | 1.8 | 27 | A | A_OUT | 110 | 010 | fall | 0.0 | 60.0 | True
rev_toffoli | ss | 1.8 | 27 | A | C_OUT | 110 | 010 | fall | 223.8991 | 75.6704 | False
rev_toffoli | ss | 1.8 | 27 | B | B_OUT | 110 | 100 | fall | 0.0 | 60.0 | True
rev_toffoli | ss | 1.8 | 27 | B | C_OUT | 110 | 100 | fall | 272.1772 | 77.6965 | False
rev_toffoli | ss | 1.8 | 27 | C | C_OUT | 110 | 111 | fall | 113.5032 | 82.8785 | False
rev_toffoli | ss | 1.8 | 27 | A | A_OUT | 111 | 011 | fall | 0.0 | 60.0 | True
rev_toffoli | ss | 1.8 | 27 | A | C_OUT | 111 | 011 | rise | 267.2715 | 157.3783 | False
rev_toffoli | ss | 1.8 | 27 | B | B_OUT | 111 | 101 | fall | 0.0 | 60.0 | True
rev_toffoli | ss | 1.8 | 27 | B | C_OUT | 111 | 101 | rise | 315.8248 | 158.1244 | False
rev_toffoli | ss | 1.8 | 27 | C | C_OUT | 111 | 110 | rise | 264.1057 | 354.1556 | False
rev_toffoli | ss | 1.62 | 125 | A | A_OUT | 000 | 100 | rise | 0.0 | 60.0 | True
rev_toffoli | ss | 1.62 | 125 | B | B_OUT | 000 | 010 | rise | 0.0 | 60.0 | True
rev_toffoli | ss | 1.62 | 125 | C | C_OUT | 000 | 001 | rise | 79.1841 | 185.2706 | False
rev_toffoli | ss | 1.62 | 125 | A | A_OUT | 001 | 101 | rise | 0.0 | 60.0 | True
rev_toffoli | ss | 1.62 | 125 | B | B_OUT | 001 | 011 | rise | 0.0 | 60.0 | True
rev_toffoli | ss | 1.62 | 125 | C | C_OUT | 001 | 000 | fall | 65.0112 | 74.7323 | False
rev_toffoli | ss | 1.62 | 125 | A | A_OUT | 010 | 110 | rise | 0.0 | 60.0 | True
rev_toffoli | ss | 1.62 | 125 | A | C_OUT | 010 | 110 | rise | 301.4384 | 353.201 | False
rev_toffoli | ss | 1.62 | 125 | B | B_OUT | 010 | 000 | fall | 0.0 | 60.0 | True
rev_toffoli | ss | 1.62 | 125 | C | C_OUT | 010 | 011 | rise | 76.5411 | 183.3942 | False
rev_toffoli | ss | 1.62 | 125 | A | A_OUT | 011 | 111 | rise | 0.0 | 60.0 | True
rev_toffoli | ss | 1.62 | 125 | A | C_OUT | 011 | 111 | fall | 236.7471 | 141.1745 | False
rev_toffoli | ss | 1.62 | 125 | B | B_OUT | 011 | 001 | fall | 0.0 | 60.0 | True
rev_toffoli | ss | 1.62 | 125 | C | C_OUT | 011 | 010 | fall | 66.7878 | 77.6625 | False
rev_toffoli | ss | 1.62 | 125 | A | A_OUT | 100 | 000 | fall | 0.0 | 60.0 | True
rev_toffoli | ss | 1.62 | 125 | B | B_OUT | 100 | 110 | rise | 0.0 | 60.0 | True
rev_toffoli | ss | 1.62 | 125 | B | C_OUT | 100 | 110 | rise | 310.4769 | 353.2786 | False
rev_toffoli | ss | 1.62 | 125 | C | C_OUT | 100 | 101 | rise | 76.55 | 183.4002 | False
rev_toffoli | ss | 1.62 | 125 | A | A_OUT | 101 | 001 | fall | 0.0 | 60.0 | True
rev_toffoli | ss | 1.62 | 125 | B | B_OUT | 101 | 111 | rise | 0.0 | 60.0 | True
rev_toffoli | ss | 1.62 | 125 | B | C_OUT | 101 | 111 | fall | 245.2704 | 141.17 | False
rev_toffoli | ss | 1.62 | 125 | C | C_OUT | 101 | 100 | fall | 66.7953 | 77.6719 | False
rev_toffoli | ss | 1.62 | 125 | A | A_OUT | 110 | 010 | fall | 0.0 | 60.0 | True
rev_toffoli | ss | 1.62 | 125 | A | C_OUT | 110 | 010 | fall | 256.3537 | 96.398 | False
rev_toffoli | ss | 1.62 | 125 | B | B_OUT | 110 | 100 | fall | 0.0 | 60.0 | True
rev_toffoli | ss | 1.62 | 125 | B | C_OUT | 110 | 100 | fall | 306.4186 | 98.9246 | False
rev_toffoli | ss | 1.62 | 125 | C | C_OUT | 110 | 111 | fall | 150.7682 | 125.0512 | False
rev_toffoli | ss | 1.62 | 125 | A | A_OUT | 111 | 011 | fall | 0.0 | 60.0 | True
rev_toffoli | ss | 1.62 | 125 | A | C_OUT | 111 | 011 | rise | 300.0312 | 172.7907 | False
rev_toffoli | ss | 1.62 | 125 | B | B_OUT | 111 | 101 | fall | 0.0 | 60.0 | True
rev_toffoli | ss | 1.62 | 125 | B | C_OUT | 111 | 101 | rise | 350.147 | 173.4597 | False
rev_toffoli | ss | 1.62 | 125 | C | C_OUT | 111 | 110 | rise | 285.1147 | 387.6169 | False
rev_toffoli | ss | 1.98 | -40 | A | A_OUT | 000 | 100 | rise | 0.0 | 60.0 | True
rev_toffoli | ss | 1.98 | -40 | B | B_OUT | 000 | 010 | rise | 0.0 | 60.0 | True
rev_toffoli | ss | 1.98 | -40 | C | C_OUT | 000 | 001 | rise | 56.0896 | 159.4345 | False
rev_toffoli | ss | 1.98 | -40 | A | A_OUT | 001 | 101 | rise | 0.0 | 60.0 | True
rev_toffoli | ss | 1.98 | -40 | B | B_OUT | 001 | 011 | rise | 0.0 | 60.0 | True
rev_toffoli | ss | 1.98 | -40 | C | C_OUT | 001 | 000 | fall | 48.676 | 48.7947 | False
rev_toffoli | ss | 1.98 | -40 | A | A_OUT | 010 | 110 | rise | 0.0 | 60.0 | True
rev_toffoli | ss | 1.98 | -40 | A | C_OUT | 010 | 110 | rise | 221.4448 | 278.2391 | False
rev_toffoli | ss | 1.98 | -40 | B | B_OUT | 010 | 000 | fall | 0.0 | 60.0 | True
rev_toffoli | ss | 1.98 | -40 | C | C_OUT | 010 | 011 | rise | 53.5521 | 157.2084 | False
rev_toffoli | ss | 1.98 | -40 | A | A_OUT | 011 | 111 | rise | 0.0 | 60.0 | True
rev_toffoli | ss | 1.98 | -40 | A | C_OUT | 011 | 111 | fall | 156.2923 | 74.0996 | False
rev_toffoli | ss | 1.98 | -40 | B | B_OUT | 011 | 001 | fall | 0.0 | 60.0 | True
rev_toffoli | ss | 1.98 | -40 | C | C_OUT | 011 | 010 | fall | 49.8039 | 50.2504 | False
rev_toffoli | ss | 1.98 | -40 | A | A_OUT | 100 | 000 | fall | 0.0 | 60.0 | True
rev_toffoli | ss | 1.98 | -40 | B | B_OUT | 100 | 110 | rise | 0.0 | 60.0 | True
rev_toffoli | ss | 1.98 | -40 | B | C_OUT | 100 | 110 | rise | 225.3655 | 278.3864 | False
rev_toffoli | ss | 1.98 | -40 | C | C_OUT | 100 | 101 | rise | 53.556 | 157.212 | False
rev_toffoli | ss | 1.98 | -40 | A | A_OUT | 101 | 001 | fall | 0.0 | 60.0 | True
rev_toffoli | ss | 1.98 | -40 | B | B_OUT | 101 | 111 | rise | 0.0 | 60.0 | True
rev_toffoli | ss | 1.98 | -40 | B | C_OUT | 101 | 111 | fall | 159.4488 | 73.9786 | False
rev_toffoli | ss | 1.98 | -40 | C | C_OUT | 101 | 100 | fall | 49.8064 | 50.2524 | False
rev_toffoli | ss | 1.98 | -40 | A | A_OUT | 110 | 010 | fall | 0.0 | 60.0 | True
rev_toffoli | ss | 1.98 | -40 | A | C_OUT | 110 | 010 | fall | 193.2859 | 61.9912 | False
rev_toffoli | ss | 1.98 | -40 | B | B_OUT | 110 | 100 | fall | 0.0 | 60.0 | True
rev_toffoli | ss | 1.98 | -40 | B | C_OUT | 110 | 100 | fall | 237.9338 | 63.7962 | False
rev_toffoli | ss | 1.98 | -40 | C | C_OUT | 110 | 111 | fall | 89.4402 | 58.7314 | False
rev_toffoli | ss | 1.98 | -40 | A | A_OUT | 111 | 011 | fall | 0.0 | 60.0 | True
rev_toffoli | ss | 1.98 | -40 | A | C_OUT | 111 | 011 | rise | 232.6553 | 140.0612 | False
rev_toffoli | ss | 1.98 | -40 | B | B_OUT | 111 | 101 | fall | 0.0 | 60.0 | True
rev_toffoli | ss | 1.98 | -40 | B | C_OUT | 111 | 101 | rise | 277.7637 | 140.9222 | False
rev_toffoli | ss | 1.98 | -40 | C | C_OUT | 111 | 110 | rise | 232.1083 | 311.7751 | False
rev_toffoli | ff | 1.8 | 27 | A | A_OUT | 000 | 100 | rise | 0.0 | 60.0 | True
rev_toffoli | ff | 1.8 | 27 | B | B_OUT | 000 | 010 | rise | 0.0 | 60.0 | True
rev_toffoli | ff | 1.8 | 27 | C | C_OUT | 000 | 001 | rise | 38.506 | 111.7488 | False
rev_toffoli | ff | 1.8 | 27 | A | A_OUT | 001 | 101 | rise | 0.0 | 60.0 | True
rev_toffoli | ff | 1.8 | 27 | B | B_OUT | 001 | 011 | rise | 0.0 | 60.0 | True
rev_toffoli | ff | 1.8 | 27 | C | C_OUT | 001 | 000 | fall | 38.9907 | 53.7714 | False
rev_toffoli | ff | 1.8 | 27 | A | A_OUT | 010 | 110 | rise | 0.0 | 60.0 | True
rev_toffoli | ff | 1.8 | 27 | A | C_OUT | 010 | 110 | rise | 133.9927 | 164.2435 | False
rev_toffoli | ff | 1.8 | 27 | B | B_OUT | 010 | 000 | fall | 0.0 | 60.0 | True
rev_toffoli | ff | 1.8 | 27 | C | C_OUT | 010 | 011 | rise | 37.0381 | 110.9467 | False
rev_toffoli | ff | 1.8 | 27 | A | A_OUT | 011 | 111 | rise | 0.0 | 60.0 | True
rev_toffoli | ff | 1.8 | 27 | A | C_OUT | 011 | 111 | fall | 109.0479 | 63.4617 | False
rev_toffoli | ff | 1.8 | 27 | B | B_OUT | 011 | 001 | fall | 0.0 | 60.0 | True
rev_toffoli | ff | 1.8 | 27 | C | C_OUT | 011 | 010 | fall | 39.768 | 54.7171 | False
rev_toffoli | ff | 1.8 | 27 | A | A_OUT | 100 | 000 | fall | 0.0 | 60.0 | True
rev_toffoli | ff | 1.8 | 27 | B | B_OUT | 100 | 110 | rise | 0.0 | 60.0 | True
rev_toffoli | ff | 1.8 | 27 | B | C_OUT | 100 | 110 | rise | 138.5452 | 164.3617 | False
rev_toffoli | ff | 1.8 | 27 | C | C_OUT | 100 | 101 | rise | 37.041 | 110.9489 | False
rev_toffoli | ff | 1.8 | 27 | A | A_OUT | 101 | 001 | fall | 0.0 | 60.0 | True
rev_toffoli | ff | 1.8 | 27 | B | B_OUT | 101 | 111 | rise | 0.0 | 60.0 | True
rev_toffoli | ff | 1.8 | 27 | B | C_OUT | 101 | 111 | fall | 113.0623 | 63.4928 | False
rev_toffoli | ff | 1.8 | 27 | C | C_OUT | 101 | 100 | fall | 39.7696 | 54.7183 | False
rev_toffoli | ff | 1.8 | 27 | A | A_OUT | 110 | 010 | fall | 0.0 | 60.0 | True
rev_toffoli | ff | 1.8 | 27 | A | C_OUT | 110 | 010 | fall | 123.3681 | 49.5657 | False
rev_toffoli | ff | 1.8 | 27 | B | B_OUT | 110 | 100 | fall | 0.0 | 60.0 | True
rev_toffoli | ff | 1.8 | 27 | B | C_OUT | 110 | 100 | fall | 145.7429 | 51.4165 | False
rev_toffoli | ff | 1.8 | 27 | C | C_OUT | 110 | 111 | fall | 76.8114 | 56.2137 | False
rev_toffoli | ff | 1.8 | 27 | A | A_OUT | 111 | 011 | fall | 0.0 | 60.0 | True
rev_toffoli | ff | 1.8 | 27 | A | C_OUT | 111 | 011 | rise | 140.3793 | 85.0867 | False
rev_toffoli | ff | 1.8 | 27 | B | B_OUT | 111 | 101 | fall | 0.0 | 60.0 | True
rev_toffoli | ff | 1.8 | 27 | B | C_OUT | 111 | 101 | rise | 163.219 | 85.906 | False
rev_toffoli | ff | 1.8 | 27 | C | C_OUT | 111 | 110 | rise | 134.9223 | 181.93 | False
rev_toffoli | ff | 1.62 | 125 | A | A_OUT | 000 | 100 | rise | 0.0 | 60.0 | True
rev_toffoli | ff | 1.62 | 125 | B | B_OUT | 000 | 010 | rise | 0.0 | 60.0 | True
rev_toffoli | ff | 1.62 | 125 | C | C_OUT | 000 | 001 | rise | 45.5313 | 117.9119 | False
rev_toffoli | ff | 1.62 | 125 | A | A_OUT | 001 | 101 | rise | 0.0 | 60.0 | True
rev_toffoli | ff | 1.62 | 125 | B | B_OUT | 001 | 011 | rise | 0.0 | 60.0 | True
rev_toffoli | ff | 1.62 | 125 | C | C_OUT | 001 | 000 | fall | 44.3849 | 60.767 | False
rev_toffoli | ff | 1.62 | 125 | A | A_OUT | 010 | 110 | rise | 0.0 | 60.0 | True
rev_toffoli | ff | 1.62 | 125 | A | C_OUT | 010 | 110 | rise | 159.4592 | 186.7385 | False
rev_toffoli | ff | 1.62 | 125 | B | B_OUT | 010 | 000 | fall | 0.0 | 60.0 | True
rev_toffoli | ff | 1.62 | 125 | C | C_OUT | 010 | 011 | rise | 44.1923 | 117.1463 | False
rev_toffoli | ff | 1.62 | 125 | A | A_OUT | 011 | 111 | rise | 0.0 | 60.0 | True
rev_toffoli | ff | 1.62 | 125 | A | C_OUT | 011 | 111 | fall | 135.5206 | 84.8377 | False
rev_toffoli | ff | 1.62 | 125 | B | B_OUT | 011 | 001 | fall | 0.0 | 60.0 | True
rev_toffoli | ff | 1.62 | 125 | C | C_OUT | 011 | 010 | fall | 45.1985 | 61.9758 | False
rev_toffoli | ff | 1.62 | 125 | A | A_OUT | 100 | 000 | fall | 0.0 | 60.0 | True
rev_toffoli | ff | 1.62 | 125 | B | B_OUT | 100 | 110 | rise | 0.0 | 60.0 | True
rev_toffoli | ff | 1.62 | 125 | B | C_OUT | 100 | 110 | rise | 165.2427 | 186.8203 | False
rev_toffoli | ff | 1.62 | 125 | C | C_OUT | 100 | 101 | rise | 44.1955 | 117.149 | False
rev_toffoli | ff | 1.62 | 125 | A | A_OUT | 101 | 001 | fall | 0.0 | 60.0 | True
rev_toffoli | ff | 1.62 | 125 | B | B_OUT | 101 | 111 | rise | 0.0 | 60.0 | True
rev_toffoli | ff | 1.62 | 125 | B | C_OUT | 101 | 111 | fall | 140.749 | 84.8441 | False
rev_toffoli | ff | 1.62 | 125 | C | C_OUT | 101 | 100 | fall | 45.2008 | 61.9779 | False
rev_toffoli | ff | 1.62 | 125 | A | A_OUT | 110 | 010 | fall | 0.0 | 60.0 | True
rev_toffoli | ff | 1.62 | 125 | A | C_OUT | 110 | 010 | fall | 141.0611 | 59.6486 | False
rev_toffoli | ff | 1.62 | 125 | B | B_OUT | 110 | 100 | fall | 0.0 | 60.0 | True
rev_toffoli | ff | 1.62 | 125 | B | C_OUT | 110 | 100 | fall | 165.4583 | 61.5915 | False
rev_toffoli | ff | 1.62 | 125 | C | C_OUT | 110 | 111 | fall | 95.3147 | 77.2097 | False
rev_toffoli | ff | 1.62 | 125 | A | A_OUT | 111 | 011 | fall | 0.0 | 60.0 | True
rev_toffoli | ff | 1.62 | 125 | A | C_OUT | 111 | 011 | rise | 160.1752 | 96.3509 | False
rev_toffoli | ff | 1.62 | 125 | B | B_OUT | 111 | 101 | fall | 0.0 | 60.0 | True
rev_toffoli | ff | 1.62 | 125 | B | C_OUT | 111 | 101 | rise | 184.9901 | 97.1047 | False
rev_toffoli | ff | 1.62 | 125 | C | C_OUT | 111 | 110 | rise | 151.2856 | 204.7829 | False
rev_toffoli | ff | 1.98 | -40 | A | A_OUT | 000 | 100 | rise | 0.0 | 60.0 | True
rev_toffoli | ff | 1.98 | -40 | B | B_OUT | 000 | 010 | rise | 0.0 | 60.0 | True
rev_toffoli | ff | 1.98 | -40 | C | C_OUT | 000 | 001 | rise | 31.337 | 107.4461 | False
rev_toffoli | ff | 1.98 | -40 | A | A_OUT | 001 | 101 | rise | 0.0 | 60.0 | True
rev_toffoli | ff | 1.98 | -40 | B | B_OUT | 001 | 011 | rise | 0.0 | 60.0 | True
rev_toffoli | ff | 1.98 | -40 | C | C_OUT | 001 | 000 | fall | 34.2948 | 49.155 | False
rev_toffoli | ff | 1.98 | -40 | A | A_OUT | 010 | 110 | rise | 0.0 | 60.0 | True
rev_toffoli | ff | 1.98 | -40 | A | C_OUT | 010 | 110 | rise | 114.5776 | 150.6016 | False
rev_toffoli | ff | 1.98 | -40 | B | B_OUT | 010 | 000 | fall | 0.0 | 60.0 | True
rev_toffoli | ff | 1.98 | -40 | C | C_OUT | 010 | 011 | rise | 29.5539 | 106.6609 | False
rev_toffoli | ff | 1.98 | -40 | A | A_OUT | 011 | 111 | rise | 0.0 | 60.0 | True
rev_toffoli | ff | 1.98 | -40 | A | C_OUT | 011 | 111 | fall | 89.9989 | 51.0862 | False
rev_toffoli | ff | 1.98 | -40 | B | B_OUT | 011 | 001 | fall | 0.0 | 60.0 | True
rev_toffoli | ff | 1.98 | -40 | C | C_OUT | 011 | 010 | fall | 35.0694 | 49.9846 | False
rev_toffoli | ff | 1.98 | -40 | A | A_OUT | 100 | 000 | fall | 0.0 | 60.0 | True
rev_toffoli | ff | 1.98 | -40 | B | B_OUT | 100 | 110 | rise | 0.0 | 60.0 | True
rev_toffoli | ff | 1.98 | -40 | B | C_OUT | 100 | 110 | rise | 118.8374 | 150.7779 | False
rev_toffoli | ff | 1.98 | -40 | C | C_OUT | 100 | 101 | rise | 29.5564 | 106.6628 | False
rev_toffoli | ff | 1.98 | -40 | A | A_OUT | 101 | 001 | fall | 0.0 | 60.0 | True
rev_toffoli | ff | 1.98 | -40 | B | B_OUT | 101 | 111 | rise | 0.0 | 60.0 | True
rev_toffoli | ff | 1.98 | -40 | B | C_OUT | 101 | 111 | fall | 93.7803 | 50.9454 | False
rev_toffoli | ff | 1.98 | -40 | C | C_OUT | 101 | 100 | fall | 35.0708 | 49.9855 | False
rev_toffoli | ff | 1.98 | -40 | A | A_OUT | 110 | 010 | fall | 0.0 | 60.0 | True
rev_toffoli | ff | 1.98 | -40 | A | C_OUT | 110 | 010 | fall | 110.3068 | 43.2825 | False
rev_toffoli | ff | 1.98 | -40 | B | B_OUT | 110 | 100 | fall | 0.0 | 60.0 | True
rev_toffoli | ff | 1.98 | -40 | B | C_OUT | 110 | 100 | fall | 131.1617 | 45.3432 | False
rev_toffoli | ff | 1.98 | -40 | C | C_OUT | 110 | 111 | fall | 64.5822 | 44.8395 | False
rev_toffoli | ff | 1.98 | -40 | A | A_OUT | 111 | 011 | fall | 0.0 | 60.0 | True
rev_toffoli | ff | 1.98 | -40 | A | C_OUT | 111 | 011 | rise | 126.1037 | 78.7556 | False
rev_toffoli | ff | 1.98 | -40 | B | B_OUT | 111 | 101 | fall | 0.0 | 60.0 | True
rev_toffoli | ff | 1.98 | -40 | B | C_OUT | 111 | 101 | rise | 147.6454 | 79.7574 | False
rev_toffoli | ff | 1.98 | -40 | C | C_OUT | 111 | 110 | rise | 121.2083 | 167.493 | False
rev_toffoli | sf | 1.8 | 27 | A | A_OUT | 000 | 100 | rise | 0.0 | 60.0 | True
rev_toffoli | sf | 1.8 | 27 | B | B_OUT | 000 | 010 | rise | 0.0 | 60.0 | True
rev_toffoli | sf | 1.8 | 27 | C | C_OUT | 000 | 001 | rise | 45.7321 | 156.5466 | False
rev_toffoli | sf | 1.8 | 27 | A | A_OUT | 001 | 101 | rise | 0.0 | 60.0 | True
rev_toffoli | sf | 1.8 | 27 | B | B_OUT | 001 | 011 | rise | 0.0 | 60.0 | True
rev_toffoli | sf | 1.8 | 27 | C | C_OUT | 001 | 000 | fall | 45.3019 | 47.7195 | False
rev_toffoli | sf | 1.8 | 27 | A | A_OUT | 010 | 110 | rise | 0.0 | 60.0 | True
rev_toffoli | sf | 1.8 | 27 | A | C_OUT | 010 | 110 | rise | 208.227 | 298.9097 | False
rev_toffoli | sf | 1.8 | 27 | B | B_OUT | 010 | 000 | fall | 0.0 | 60.0 | True
rev_toffoli | sf | 1.8 | 27 | C | C_OUT | 010 | 011 | rise | 43.2405 | 154.155 | False
rev_toffoli | sf | 1.8 | 27 | A | A_OUT | 011 | 111 | rise | 0.0 | 60.0 | True
rev_toffoli | sf | 1.8 | 27 | A | C_OUT | 011 | 111 | fall | 151.9424 | 72.7631 | False
rev_toffoli | sf | 1.8 | 27 | B | B_OUT | 011 | 001 | fall | 0.0 | 60.0 | True
rev_toffoli | sf | 1.8 | 27 | C | C_OUT | 011 | 010 | fall | 46.4088 | 48.9646 | False
rev_toffoli | sf | 1.8 | 27 | A | A_OUT | 100 | 000 | fall | 0.0 | 60.0 | True
rev_toffoli | sf | 1.8 | 27 | B | B_OUT | 100 | 110 | rise | 0.0 | 60.0 | True
rev_toffoli | sf | 1.8 | 27 | B | C_OUT | 100 | 110 | rise | 212.105 | 299.2026 | False
rev_toffoli | sf | 1.8 | 27 | C | C_OUT | 100 | 101 | rise | 43.2453 | 154.1616 | False
rev_toffoli | sf | 1.8 | 27 | A | A_OUT | 101 | 001 | fall | 0.0 | 60.0 | True
rev_toffoli | sf | 1.8 | 27 | B | B_OUT | 101 | 111 | rise | 0.0 | 60.0 | True
rev_toffoli | sf | 1.8 | 27 | B | C_OUT | 101 | 111 | fall | 155.046 | 72.7394 | False
rev_toffoli | sf | 1.8 | 27 | C | C_OUT | 101 | 100 | fall | 46.4125 | 48.9671 | False
rev_toffoli | sf | 1.8 | 27 | A | A_OUT | 110 | 010 | fall | 0.0 | 60.0 | True
rev_toffoli | sf | 1.8 | 27 | A | C_OUT | 110 | 010 | fall | 188.9961 | 65.4944 | False
rev_toffoli | sf | 1.8 | 27 | B | B_OUT | 110 | 100 | fall | 0.0 | 60.0 | True
rev_toffoli | sf | 1.8 | 27 | B | C_OUT | 110 | 100 | fall | 230.4363 | 70.0406 | False
rev_toffoli | sf | 1.8 | 27 | C | C_OUT | 110 | 111 | fall | 80.0274 | 56.4735 | False
rev_toffoli | sf | 1.8 | 27 | A | A_OUT | 111 | 011 | fall | 0.0 | 60.0 | True
rev_toffoli | sf | 1.8 | 27 | A | C_OUT | 111 | 011 | rise | 226.7246 | 147.9728 | False
rev_toffoli | sf | 1.8 | 27 | B | B_OUT | 111 | 101 | fall | 0.0 | 60.0 | True
rev_toffoli | sf | 1.8 | 27 | B | C_OUT | 111 | 101 | rise | 270.514 | 150.3017 | False
rev_toffoli | sf | 1.8 | 27 | C | C_OUT | 111 | 110 | rise | 228.2139 | 336.2243 | False
rev_toffoli | sf | 1.62 | 125 | A | A_OUT | 000 | 100 | rise | 0.0 | 60.0 | True
rev_toffoli | sf | 1.62 | 125 | B | B_OUT | 000 | 010 | rise | 0.0 | 60.0 | True
rev_toffoli | sf | 1.62 | 125 | C | C_OUT | 000 | 001 | rise | 54.8125 | 173.2328 | False
rev_toffoli | sf | 1.62 | 125 | A | A_OUT | 001 | 101 | rise | 0.0 | 60.0 | True
rev_toffoli | sf | 1.62 | 125 | B | B_OUT | 001 | 011 | rise | 0.0 | 60.0 | True
rev_toffoli | sf | 1.62 | 125 | C | C_OUT | 001 | 000 | fall | 51.4761 | 55.7627 | False
rev_toffoli | sf | 1.62 | 125 | A | A_OUT | 010 | 110 | rise | 0.0 | 60.0 | True
rev_toffoli | sf | 1.62 | 125 | A | C_OUT | 010 | 110 | rise | 248.1824 | 347.3868 | False
rev_toffoli | sf | 1.62 | 125 | B | B_OUT | 010 | 000 | fall | 0.0 | 60.0 | True
rev_toffoli | sf | 1.62 | 125 | C | C_OUT | 010 | 011 | rise | 52.1758 | 170.5623 | False
rev_toffoli | sf | 1.62 | 125 | A | A_OUT | 011 | 111 | rise | 0.0 | 60.0 | True
rev_toffoli | sf | 1.62 | 125 | A | C_OUT | 011 | 111 | fall | 184.6132 | 96.2617 | False
rev_toffoli | sf | 1.62 | 125 | B | B_OUT | 011 | 001 | fall | 0.0 | 60.0 | True
rev_toffoli | sf | 1.62 | 125 | C | C_OUT | 011 | 010 | fall | 52.6834 | 57.5264 | False
rev_toffoli | sf | 1.62 | 125 | A | A_OUT | 100 | 000 | fall | 0.0 | 60.0 | True
rev_toffoli | sf | 1.62 | 125 | B | B_OUT | 100 | 110 | rise | 0.0 | 60.0 | True
rev_toffoli | sf | 1.62 | 125 | B | C_OUT | 100 | 110 | rise | 253.4849 | 347.5921 | False
rev_toffoli | sf | 1.62 | 125 | C | C_OUT | 100 | 101 | rise | 52.1831 | 170.5715 | False
rev_toffoli | sf | 1.62 | 125 | A | A_OUT | 101 | 001 | fall | 0.0 | 60.0 | True
rev_toffoli | sf | 1.62 | 125 | B | B_OUT | 101 | 111 | rise | 0.0 | 60.0 | True
rev_toffoli | sf | 1.62 | 125 | B | C_OUT | 101 | 111 | fall | 189.0923 | 96.2352 | False
rev_toffoli | sf | 1.62 | 125 | C | C_OUT | 101 | 100 | fall | 52.689 | 57.53 | False
rev_toffoli | sf | 1.62 | 125 | A | A_OUT | 110 | 010 | fall | 0.0 | 60.0 | True
rev_toffoli | sf | 1.62 | 125 | A | C_OUT | 110 | 010 | fall | 214.8804 | 78.3647 | False
rev_toffoli | sf | 1.62 | 125 | B | B_OUT | 110 | 100 | fall | 0.0 | 60.0 | True
rev_toffoli | sf | 1.62 | 125 | B | C_OUT | 110 | 100 | fall | 260.055 | 82.6404 | False
rev_toffoli | sf | 1.62 | 125 | C | C_OUT | 110 | 111 | fall | 100.5056 | 78.0349 | False
rev_toffoli | sf | 1.62 | 125 | A | A_OUT | 111 | 011 | fall | 0.0 | 60.0 | True
rev_toffoli | sf | 1.62 | 125 | A | C_OUT | 111 | 011 | rise | 256.6408 | 168.2782 | False
rev_toffoli | sf | 1.62 | 125 | B | B_OUT | 111 | 101 | fall | 0.0 | 60.0 | True
rev_toffoli | sf | 1.62 | 125 | B | C_OUT | 111 | 101 | rise | 303.5897 | 170.2234 | False
rev_toffoli | sf | 1.62 | 125 | C | C_OUT | 111 | 110 | rise | 254.8993 | 383.6264 | False
rev_toffoli | sf | 1.98 | -40 | A | A_OUT | 000 | 100 | rise | 0.0 | 60.0 | True
rev_toffoli | sf | 1.98 | -40 | B | B_OUT | 000 | 010 | rise | 0.0 | 60.0 | True
rev_toffoli | sf | 1.98 | -40 | C | C_OUT | 000 | 001 | rise | 36.6923 | 139.3076 | False
rev_toffoli | sf | 1.98 | -40 | A | A_OUT | 001 | 101 | rise | 0.0 | 60.0 | True
rev_toffoli | sf | 1.98 | -40 | B | B_OUT | 001 | 011 | rise | 0.0 | 60.0 | True
rev_toffoli | sf | 1.98 | -40 | C | C_OUT | 001 | 000 | fall | 39.6425 | 43.6064 | False
rev_toffoli | sf | 1.98 | -40 | A | A_OUT | 010 | 110 | rise | 0.0 | 60.0 | True
rev_toffoli | sf | 1.98 | -40 | A | C_OUT | 010 | 110 | rise | 169.0218 | 249.1533 | False
rev_toffoli | sf | 1.98 | -40 | B | B_OUT | 010 | 000 | fall | 0.0 | 60.0 | True
rev_toffoli | sf | 1.98 | -40 | C | C_OUT | 010 | 011 | rise | 33.9392 | 137.3947 | False
rev_toffoli | sf | 1.98 | -40 | A | A_OUT | 011 | 111 | rise | 0.0 | 60.0 | True
rev_toffoli | sf | 1.98 | -40 | A | C_OUT | 011 | 111 | fall | 123.8059 | 58.0141 | False
rev_toffoli | sf | 1.98 | -40 | B | B_OUT | 011 | 001 | fall | 0.0 | 60.0 | True
rev_toffoli | sf | 1.98 | -40 | C | C_OUT | 011 | 010 | fall | 40.6792 | 44.6028 | False
rev_toffoli | sf | 1.98 | -40 | A | A_OUT | 100 | 000 | fall | 0.0 | 60.0 | True
rev_toffoli | sf | 1.98 | -40 | B | B_OUT | 100 | 110 | rise | 0.0 | 60.0 | True
rev_toffoli | sf | 1.98 | -40 | B | C_OUT | 100 | 110 | rise | 172.538 | 249.4759 | False
rev_toffoli | sf | 1.98 | -40 | C | C_OUT | 100 | 101 | rise | 33.9432 | 137.3994 | False
rev_toffoli | sf | 1.98 | -40 | A | A_OUT | 101 | 001 | fall | 0.0 | 60.0 | True
rev_toffoli | sf | 1.98 | -40 | B | B_OUT | 101 | 111 | rise | 0.0 | 60.0 | True
rev_toffoli | sf | 1.98 | -40 | B | C_OUT | 101 | 111 | fall | 126.7155 | 57.9022 | False
rev_toffoli | sf | 1.98 | -40 | C | C_OUT | 101 | 100 | fall | 40.6821 | 44.6043 | False
rev_toffoli | sf | 1.98 | -40 | A | A_OUT | 110 | 010 | fall | 0.0 | 60.0 | True
rev_toffoli | sf | 1.98 | -40 | A | C_OUT | 110 | 010 | fall | 162.9419 | 55.5888 | False
rev_toffoli | sf | 1.98 | -40 | B | B_OUT | 110 | 100 | fall | 0.0 | 60.0 | True
rev_toffoli | sf | 1.98 | -40 | B | C_OUT | 110 | 100 | fall | 198.7034 | 60.5824 | False
rev_toffoli | sf | 1.98 | -40 | C | C_OUT | 110 | 111 | fall | 66.4894 | 44.5144 | False
rev_toffoli | sf | 1.98 | -40 | A | A_OUT | 111 | 011 | fall | 0.0 | 60.0 | True
rev_toffoli | sf | 1.98 | -40 | A | C_OUT | 111 | 011 | rise | 194.6328 | 126.2337 | False
rev_toffoli | sf | 1.98 | -40 | B | B_OUT | 111 | 101 | fall | 0.0 | 60.0 | True
rev_toffoli | sf | 1.98 | -40 | B | C_OUT | 111 | 101 | rise | 233.2645 | 128.9429 | False
rev_toffoli | sf | 1.98 | -40 | C | C_OUT | 111 | 110 | rise | 194.8812 | 283.9545 | False
rev_toffoli | fs | 1.8 | 27 | A | A_OUT | 000 | 100 | rise | 0.0 | 60.0 | True
rev_toffoli | fs | 1.8 | 27 | B | B_OUT | 000 | 010 | rise | 0.0 | 60.0 | True
rev_toffoli | fs | 1.8 | 27 | C | C_OUT | 000 | 001 | rise | 50.9424 | 116.3086 | False
rev_toffoli | fs | 1.8 | 27 | A | A_OUT | 001 | 101 | rise | 0.0 | 60.0 | True
rev_toffoli | fs | 1.8 | 27 | B | B_OUT | 001 | 011 | rise | 0.0 | 60.0 | True
rev_toffoli | fs | 1.8 | 27 | C | C_OUT | 001 | 000 | fall | 47.0553 | 65.4745 | False
rev_toffoli | fs | 1.8 | 27 | A | A_OUT | 010 | 110 | rise | 0.0 | 60.0 | True
rev_toffoli | fs | 1.8 | 27 | A | C_OUT | 010 | 110 | rise | 164.3074 | 169.9548 | False
rev_toffoli | fs | 1.8 | 27 | B | B_OUT | 010 | 000 | fall | 0.0 | 60.0 | True
rev_toffoli | fs | 1.8 | 27 | C | C_OUT | 010 | 011 | rise | 49.6663 | 115.764 | False
rev_toffoli | fs | 1.8 | 27 | A | A_OUT | 011 | 111 | rise | 0.0 | 60.0 | True
rev_toffoli | fs | 1.8 | 27 | A | C_OUT | 011 | 111 | fall | 141.0218 | 88.2786 | False
rev_toffoli | fs | 1.8 | 27 | B | B_OUT | 011 | 001 | fall | 0.0 | 60.0 | True
rev_toffoli | fs | 1.8 | 27 | C | C_OUT | 011 | 010 | fall | 47.7631 | 66.9423 | False
rev_toffoli | fs | 1.8 | 27 | A | A_OUT | 100 | 000 | fall | 0.0 | 60.0 | True
rev_toffoli | fs | 1.8 | 27 | B | B_OUT | 100 | 110 | rise | 0.0 | 60.0 | True
rev_toffoli | fs | 1.8 | 27 | B | C_OUT | 100 | 110 | rise | 170.2743 | 169.9945 | False
rev_toffoli | fs | 1.8 | 27 | C | C_OUT | 100 | 101 | rise | 49.6682 | 115.765 | False
rev_toffoli | fs | 1.8 | 27 | A | A_OUT | 101 | 001 | fall | 0.0 | 60.0 | True
rev_toffoli | fs | 1.8 | 27 | B | B_OUT | 101 | 111 | rise | 0.0 | 60.0 | True
rev_toffoli | fs | 1.8 | 27 | B | C_OUT | 101 | 111 | fall | 146.5472 | 88.3195 | False
rev_toffoli | fs | 1.8 | 27 | C | C_OUT | 101 | 100 | fall | 47.7646 | 66.9447 | False
rev_toffoli | fs | 1.8 | 27 | A | A_OUT | 110 | 010 | fall | 0.0 | 60.0 | True
rev_toffoli | fs | 1.8 | 27 | A | C_OUT | 110 | 010 | fall | 146.6673 | 58.5926 | False
rev_toffoli | fs | 1.8 | 27 | B | B_OUT | 110 | 100 | fall | 0.0 | 60.0 | True
rev_toffoli | fs | 1.8 | 27 | B | C_OUT | 110 | 100 | fall | 172.1536 | 59.7075 | False
rev_toffoli | fs | 1.8 | 27 | C | C_OUT | 110 | 111 | fall | 105.8912 | 81.2633 | False
rev_toffoli | fs | 1.8 | 27 | A | A_OUT | 111 | 011 | fall | 0.0 | 60.0 | True
rev_toffoli | fs | 1.8 | 27 | A | C_OUT | 111 | 011 | rise | 166.9238 | 90.8637 | False
rev_toffoli | fs | 1.8 | 27 | B | B_OUT | 111 | 101 | fall | 0.0 | 60.0 | True
rev_toffoli | fs | 1.8 | 27 | B | C_OUT | 111 | 101 | rise | 192.3447 | 91.1393 | False
rev_toffoli | fs | 1.8 | 27 | C | C_OUT | 111 | 110 | rise | 150.4977 | 187.6523 | False
rev_toffoli | fs | 1.62 | 125 | A | A_OUT | 000 | 100 | rise | 0.0 | 60.0 | True
rev_toffoli | fs | 1.62 | 125 | B | B_OUT | 000 | 010 | rise | 0.0 | 60.0 | True
rev_toffoli | fs | 1.62 | 125 | C | C_OUT | 000 | 001 | rise | 59.7601 | 123.3404 | False
rev_toffoli | fs | 1.62 | 125 | A | A_OUT | 001 | 101 | rise | 0.0 | 60.0 | True
rev_toffoli | fs | 1.62 | 125 | B | B_OUT | 001 | 011 | rise | 0.0 | 60.0 | True
rev_toffoli | fs | 1.62 | 125 | C | C_OUT | 001 | 000 | fall | 54.3892 | 79.6696 | False
rev_toffoli | fs | 1.62 | 125 | A | A_OUT | 010 | 110 | rise | 0.0 | 60.0 | True
rev_toffoli | fs | 1.62 | 125 | A | C_OUT | 010 | 110 | rise | 197.8113 | 197.3568 | False
rev_toffoli | fs | 1.62 | 125 | B | B_OUT | 010 | 000 | fall | 0.0 | 60.0 | True
rev_toffoli | fs | 1.62 | 125 | C | C_OUT | 010 | 011 | rise | 58.5216 | 123.0519 | False
rev_toffoli | fs | 1.62 | 125 | A | A_OUT | 011 | 111 | rise | 0.0 | 60.0 | True
rev_toffoli | fs | 1.62 | 125 | A | C_OUT | 011 | 111 | fall | 183.0238 | 130.0069 | False
rev_toffoli | fs | 1.62 | 125 | B | B_OUT | 011 | 001 | fall | 0.0 | 60.0 | True
rev_toffoli | fs | 1.62 | 125 | C | C_OUT | 011 | 010 | fall | 55.2973 | 81.4304 | False
rev_toffoli | fs | 1.62 | 125 | A | A_OUT | 100 | 000 | fall | 0.0 | 60.0 | True
rev_toffoli | fs | 1.62 | 125 | B | B_OUT | 100 | 110 | rise | 0.0 | 60.0 | True
rev_toffoli | fs | 1.62 | 125 | B | C_OUT | 100 | 110 | rise | 207.2622 | 197.3812 | False
rev_toffoli | fs | 1.62 | 125 | C | C_OUT | 100 | 101 | rise | 58.5242 | 123.0527 | False
rev_toffoli | fs | 1.62 | 125 | A | A_OUT | 101 | 001 | fall | 0.0 | 60.0 | True
rev_toffoli | fs | 1.62 | 125 | B | B_OUT | 101 | 111 | rise | 0.0 | 60.0 | True
rev_toffoli | fs | 1.62 | 125 | B | C_OUT | 101 | 111 | fall | 192.2564 | 129.9721 | False
rev_toffoli | fs | 1.62 | 125 | C | C_OUT | 101 | 100 | fall | 55.3 | 81.4355 | False
rev_toffoli | fs | 1.62 | 125 | A | A_OUT | 110 | 010 | fall | 0.0 | 60.0 | True
rev_toffoli | fs | 1.62 | 125 | A | C_OUT | 110 | 010 | fall | 176.5998 | 77.5517 | False
rev_toffoli | fs | 1.62 | 125 | B | B_OUT | 110 | 100 | fall | 0.0 | 60.0 | True
rev_toffoli | fs | 1.62 | 125 | B | C_OUT | 110 | 100 | fall | 205.1733 | 79.1061 | False
rev_toffoli | fs | 1.62 | 125 | C | C_OUT | 110 | 111 | fall | 140.2968 | 124.523 | False
rev_toffoli | fs | 1.62 | 125 | A | A_OUT | 111 | 011 | fall | 0.0 | 60.0 | True
rev_toffoli | fs | 1.62 | 125 | A | C_OUT | 111 | 011 | rise | 199.3057 | 106.8225 | False
rev_toffoli | fs | 1.62 | 125 | B | B_OUT | 111 | 101 | fall | 0.0 | 60.0 | True
rev_toffoli | fs | 1.62 | 125 | B | C_OUT | 111 | 101 | rise | 227.7701 | 107.1281 | False
rev_toffoli | fs | 1.62 | 125 | C | C_OUT | 111 | 110 | rise | 173.0939 | 215.2826 | False
rev_toffoli | fs | 1.98 | -40 | A | A_OUT | 000 | 100 | rise | 0.0 | 60.0 | True
rev_toffoli | fs | 1.98 | -40 | B | B_OUT | 000 | 010 | rise | 0.0 | 60.0 | True
rev_toffoli | fs | 1.98 | -40 | C | C_OUT | 000 | 001 | rise | 43.5769 | 112.1235 | False
rev_toffoli | fs | 1.98 | -40 | A | A_OUT | 001 | 101 | rise | 0.0 | 60.0 | True
rev_toffoli | fs | 1.98 | -40 | B | B_OUT | 001 | 011 | rise | 0.0 | 60.0 | True
rev_toffoli | fs | 1.98 | -40 | C | C_OUT | 001 | 000 | fall | 41.132 | 56.7627 | False
rev_toffoli | fs | 1.98 | -40 | A | A_OUT | 010 | 110 | rise | 0.0 | 60.0 | True
rev_toffoli | fs | 1.98 | -40 | A | C_OUT | 010 | 110 | rise | 140.2847 | 154.549 | False
rev_toffoli | fs | 1.98 | -40 | B | B_OUT | 010 | 000 | fall | 0.0 | 60.0 | True
rev_toffoli | fs | 1.98 | -40 | C | C_OUT | 010 | 011 | rise | 42.0863 | 111.3225 | False
rev_toffoli | fs | 1.98 | -40 | A | A_OUT | 011 | 111 | rise | 0.0 | 60.0 | True
rev_toffoli | fs | 1.98 | -40 | A | C_OUT | 011 | 111 | fall | 113.1957 | 64.8982 | False
rev_toffoli | fs | 1.98 | -40 | B | B_OUT | 011 | 001 | fall | 0.0 | 60.0 | True
rev_toffoli | fs | 1.98 | -40 | C | C_OUT | 011 | 010 | fall | 41.8682 | 57.8812 | False
rev_toffoli | fs | 1.98 | -40 | A | A_OUT | 100 | 000 | fall | 0.0 | 60.0 | True
rev_toffoli | fs | 1.98 | -40 | B | B_OUT | 100 | 110 | rise | 0.0 | 60.0 | True
rev_toffoli | fs | 1.98 | -40 | B | C_OUT | 100 | 110 | rise | 144.4311 | 154.6023 | False
rev_toffoli | fs | 1.98 | -40 | C | C_OUT | 100 | 101 | rise | 42.0881 | 111.3235 | False
rev_toffoli | fs | 1.98 | -40 | A | A_OUT | 101 | 001 | fall | 0.0 | 60.0 | True
rev_toffoli | fs | 1.98 | -40 | B | B_OUT | 101 | 111 | rise | 0.0 | 60.0 | True
rev_toffoli | fs | 1.98 | -40 | B | C_OUT | 101 | 111 | fall | 116.8117 | 64.818 | False
rev_toffoli | fs | 1.98 | -40 | C | C_OUT | 101 | 100 | fall | 41.8694 | 57.8829 | False
rev_toffoli | fs | 1.98 | -40 | A | A_OUT | 110 | 010 | fall | 0.0 | 60.0 | True
rev_toffoli | fs | 1.98 | -40 | A | C_OUT | 110 | 010 | fall | 126.1961 | 47.6621 | False
rev_toffoli | fs | 1.98 | -40 | B | B_OUT | 110 | 100 | fall | 0.0 | 60.0 | True
rev_toffoli | fs | 1.98 | -40 | B | C_OUT | 110 | 100 | fall | 149.9983 | 48.6558 | False
rev_toffoli | fs | 1.98 | -40 | C | C_OUT | 110 | 111 | fall | 84.158 | 56.9033 | False
rev_toffoli | fs | 1.98 | -40 | A | A_OUT | 111 | 011 | fall | 0.0 | 60.0 | True
rev_toffoli | fs | 1.98 | -40 | A | C_OUT | 111 | 011 | rise | 145.154 | 82.3788 | False
rev_toffoli | fs | 1.98 | -40 | B | B_OUT | 111 | 101 | fall | 0.0 | 60.0 | True
rev_toffoli | fs | 1.98 | -40 | B | C_OUT | 111 | 101 | rise | 168.9648 | 82.7217 | False
rev_toffoli | fs | 1.98 | -40 | C | C_OUT | 111 | 110 | rise | 133.1768 | 171.0366 | False
