bhagwat-rahul/reversible-mac/(commit log)

2026-09-07 add in everything
    [rev_cnot.sch, rev_not.sch, rev_toffoli.sch, summary.csv, tb_rev_cnot.sch, tb_rev_not.sch, tb_rev_toffoli.sch, timing.csv]
2026-09-07 a little mixed signal placement magic
    [macro_placement.cfg]
2026-09-07 fucking around with macroplace to get pdn to pass
    [macro_placement.cfg]
2026-09-07 buncha fix
    [macro_placement.cfg]
2026-09-08 more updatess
    [macro_placement.cfg]
2026-09-08 extra rows for reducing violations
    [macro_placement.cfg]
